Utemita/Optimizacion_Exo2/Analisis_DIP_Solucion_Definitiva.md

# Analisis Definitivo: Solucion al Problema DIP del Exoesqueleto

## A. Analisis de Causa Raiz - Por que el DIP es Constante

### A.1 Topologia actual del mecanismo

El exoesqueleto de mano (`CinematicaExoFinal.m` / `exo_18.py`) utiliza una cadena
cinematica de 4 etapas, todas accionadas por un unico motor:

| Etapa | Mecanismo | Salida |
|---|---|---|
| 1 | Par de engranes | theta_1, theta_2 (relacion fija) |
| 2 | 5 barras #1 + 4 barras #1 | theta_fp (falange proximal) |
| 3 | 5 barras #2 + 4 barras #2 | theta_fm (falange medial) |
| 4 | **Offset constante** | theta_fd = theta_fm + 38.78 deg |

La etapa 4 es la linea de codigo:

```python
theta_fd = theta_fm + theta_aux_fd   # theta_aux_fd = constante optimizable
```

Esto significa que el angulo relativo DIP-PIP es siempre constante. La falange
distal esta **rigidamente acoplada** a la medial, sin articulacion independiente.

### A.2 Por que el optimizador logra errores bajos a pesar de esto

Con los datos MOCAP originales (`mocap_indice_120pts.csv`), el rango DIP es solo
~20 grados. El optimizador compensa esta falta de movimiento DIP independiente
mediante:

1. Ajuste fino del offset constante para minimizar la distancia de Chamfer promedio.
2. La transformacion rigida global (R, t) absorbe parte de la discrepancia.
3. Los pesos W_IFP=0.25, W_IFD=0.375, W_TIP=0.375 permiten que la falange distal
   "siga" a la medial sin penalizacion excesiva.

Sin embargo, con datos de agarre fino (pinch) donde el DIP se mueve ~70 grados de
forma no lineal respecto al PIP, un offset constante **no puede** reproducir la
trayectoria correcta de la punta del dedo.

### A.3 Impacto fisico

Sin movimiento DIP independiente:
- La punta del dedo no realiza la curvatura necesaria para un agarre de pinza fina.
- El exoesqueleto no puede guiar la falange distal en posiciones de oposicion con
  el pulgar.
- El error en la punta aumenta significativamente con datos de pinch.

---

## B. Opcion 1: Acoplamiento Polinomial theta_aux_fd = f(delta_pip)

### B.1 Concepto

En lugar de un offset constante, hacer que `theta_aux_fd` dependa del estado del
mecanismo. La variable natural es la flexion relativa del PIP:

```
delta_pip = theta_fm - theta_fp
```

Esta cantidad es cero cuando la medial y la proximal estan alineadas, y crece a
medida que el dedo se cierra (la articulacion IFP se flexiona). La funcion de
acoplamiento es un polinomio:

```
theta_aux_fd = c0 + c1 * delta_pip + c2 * delta_pip^2
```

### B.2 Interpretacion de los coeficientes

- **c0** (termino constante): offset DIP en extension completa. Similar al antiguo
  theta_aux_fd = 38.78 deg. Rango: [0, pi].
- **c1** (termino lineal): tasa de flexion DIP por unidad de flexion PIP. Un valor
  positivo hace que el DIP se cierre mas rapido conforme el PIP se cierra.
  Rango: [-2, 2].
- **c2** (termino cuadratico): curvatura del acoplamiento. Permite que la relacion
  DIP-PIP sea no lineal (como en dedos reales). Rango: [-5, 5].

### B.3 Formulacion matematica

Dentro de `run_kinematics`, despues de resolver los mecanismos 5B#2 y 4B#2:

```python
# Calcular flexion relativa PIP
delta_pip = theta_fm - theta_fp

# Polinomio de acoplamiento DIP
theta_aux_fd = coeff_fd_0 + coeff_fd_1 * delta_pip + coeff_fd_2 * delta_pip**2

# Angulo absoluto de la falange distal
theta_fd = theta_fm + theta_aux_fd
```

### B.4 Realizacion fisica

Este acoplamiento polinomial se puede materializar en hardware como:
- **Perfil de leva (cam):** una leva en la articulacion IFP cuyo perfil controla
  la rotacion relativa del DIP. El polinomio define la geometria de la leva.
- **Ranura guia (slot):** una guia curva que convierte el movimiento PIP en
  flexion DIP a traves de un seguidor de levas.
- **Engranaje no circular:** un par de engranes con relacion de transmision
  variable que implementa la funcion polinomial.

### B.5 Ventajas

1. **Topologia identica:** los 4 mecanismos (5B+4B+5B+4B) no cambian.
2. **Complejidad minima:** solo se agregan 2 parametros (de 17 a 19 totales).
3. **Optimizable directamente:** los coeficientes se ajustan con la misma
   evolucion diferencial existente.
4. **Retrocompatible:** con c1=0, c2=0, el modelo se reduce al exo_18 original.
5. **No tiene problemas de ensamble:** no hay mecanismo fisico que pueda fallar
   en ciertas posiciones (a diferencia del 4B#3).
6. **Monotonia controlable:** se puede agregar una restriccion para que
   theta_aux_fd sea monotonamente creciente.

---

## C. Opcion 2: Acoplamiento Lineal theta_aux_fd = a0 + a1 * delta_pip

### C.1 Concepto

Caso particular de la Opcion 1 con c2 = 0:

```
theta_aux_fd = a0 + a1 * delta_pip
```

### C.2 Ventajas y limitaciones

**Ventajas:**
- Solo 1 parametro nuevo (de 17 a 18 totales).
- Muy facil de realizar fisicamente (engranaje lineal, cable con polea de radio
  fijo, o biela con relacion constante).
- Estable numericamente.

**Limitaciones:**
- La relacion DIP-PIP en un dedo real NO es lineal. La cinematica natural muestra
  aceleracion progresiva (el DIP se flexiona cada vez mas rapido conforme el PIP
  avanza).
- Con datos de pinch de alta amplitud (70 deg DIP), un modelo lineal puede no
  capturar la forma de la trayectoria de la punta.

---

## D. Opcion 3: Mecanismo Fisico de 4 Barras #3 (ya evaluada)

### D.1 Concepto

Agregar un tercer mecanismo de 4 barras que cruce la articulacion IFP, usando la
falange medial como bancada. Documentado en detalle en `Analisis_Modificacion_DIP.md`.

### D.2 Resultados obtenidos

- Excursion DIP: ~30 grados (con parametros nominales).
- Ensamble garantizado en todo el rango.
- **PROBLEMA CRITICO:** La falange distal se dobla hacia ARRIBA (hiperextension)
  en lugar de hacia abajo (flexion). El sentido de la flexion DIP es contrario
  al esperado.

### D.3 Analisis del problema de direccion

El problema de direccion ocurre porque la rama de ensamble seleccionada
(`phi3 - arccos(K3/R3)`) produce un alpha2_3 que decrece conforme se flexiona el
PIP. Para que la DIP se flexione (theta_fd aumente), alpha2_3 deberia aumentar, pero
la geometria del mecanismo impone lo contrario dada la configuracion de montaje.

Cambiar la rama de ensamble (`phi3 + arccos(K3/R3)`) o invertir signos de BETA no
es trivial, ya que puede provocar interferencias mecanicas o perdida de ensamble en
parte del rango.

### D.4 Problemas adicionales

- 5 parametros nuevos (complejidad del espacio de busqueda).
- Posibilidad de no-ensamble (`|K3| > R3`) en subconjuntos del rango.
- Restricciones geometricas de interferencia con los mecanismos existentes.
- El optimizador tiende a encontrar soluciones donde el 4B#3 se comporta como un
  offset casi constante (eliminando la ventaja de tenerlo).

---

## E. Opcion 4: Perfil de Leva o Ranura (cam/slot)

### E.1 Concepto

Disenar un perfil de leva sobre la articulacion IFP que imponga directamente el
angulo DIP como funcion del angulo PIP. La forma del perfil se optimizaria como
una spline o tabla de puntos.

### E.2 Ventajas

- Control total sobre la funcion de acoplamiento.
- Sin restricciones de ensamble.

### E.3 Limitaciones

- **Dificil de optimizar:** un perfil de leva parametrizado como spline requiere
  muchos puntos de control (10-20 parametros).
- **Fabricacion compleja:** requiere mecanizado CNC de precision.
- **No parametrizable facilmente** en el marco de optimizacion actual (evolucion
  diferencial con bounds simples).
- Si se usa un polinomio para definir el perfil de la leva, se reduce exactamente
  a la Opcion 1 (pero con la complejidad mecanica de fabricar una leva real).

---

## F. Recomendacion

### F.1 Solucion recomendada: Opcion 1 (Polinomio Cuadratico)

Se recomienda la **Opcion 1** por las siguientes razones:

1. **Conserva la topologia robusta** del mecanismo original (5B+4B+5B+4B) que
   ya demostro errores muy bajos en la optimizacion.

2. **Complejidad minima:** solo agrega 2 parametros al vector de diseno (de 17 a
   19 totales con los 3 coeficientes reemplazando el 1 constante anterior).

3. **Implementacion trivial:** 3 lineas de codigo en `run_kinematics`.

4. **Sin riesgos de ensamble:** no hay condiciones geometricas que puedan fallar.

5. **Retrocompatible:** equivalente al modelo actual con c1=c2=0.

6. **Optimizable con la infraestructura existente:** los coeficientes se agregan
   a bounds y se ajustan con la misma evolucion diferencial + Optuna.

7. **Realizable fisicamente:** el polinomio resultante define el perfil de una
   leva o engranaje no circular, cuya geometria se calcula directamente.

### F.2 Implementacion

El archivo `exo_19_dip_variable.py` implementa esta solucion:

- Vector de parametros: 19 elementos (los 17 originales con theta_aux_fd
  reemplazado por 3 coeficientes polinomiales).
- Datos MOCAP: carga `mocap_pinch_pizzolato.csv` (70 deg DIP) con fallback a
  `mocap_indice_120pts.csv`.
- Restriccion de monotonia: penaliza inversiones en la flexion DIP.
- Validacion: coeficientes (38.78 deg, 0, 0) reproducen el exo_18 original.

### F.3 Resultados esperados

Con el polinomio cuadratico, el optimizador puede:
- Encontrar la relacion DIP-PIP que mejor sigue los datos de pinch.
- Producir una trayectoria de la punta del dedo que se curva correctamente.
- Mantener errores bajos en IFP e IFD (topologia no cambia para esos puntos).
- Lograr flexion DIP progresiva y monotona (sin hiperextension).

---

## Resumen Comparativo

| Criterio | Opcion 1 (Polinomio) | Opcion 2 (Lineal) | Opcion 3 (4B#3) | Opcion 4 (Leva) |
|---|---|---|---|---|
| Params nuevos | +2 (19 total) | +1 (18 total) | +5 (22 total) | +10-20 |
| Topologia | Sin cambio | Sin cambio | Modifica | Sin cambio |
| Direccion DIP | Controlable | Controlable | Invertida | Controlable |
| Riesgo ensamble | Ninguno | Ninguno | Si | Ninguno |
| Precision DIP | Alta (no lineal) | Media (solo lineal) | Media | Alta |
| Fabricabilidad | Leva/engranaje | Cable/polea | Eslabones | Leva CNC |
| Dificultad implementacion | Minima | Minima | Alta | Alta |

**Conclusion:** La Opcion 1 (polinomio cuadratico) es la mejor combinacion de
simplicidad, precision y factibilidad para resolver el problema DIP sin
sacrificar la robustez del mecanismo original.
