Utemita/Optimizacion_Exo2/ReporteModeloCinemáticoExoPavel.pdf

## UNIVERSIDAD TECNOLÓGICA DE LA MIXTECA

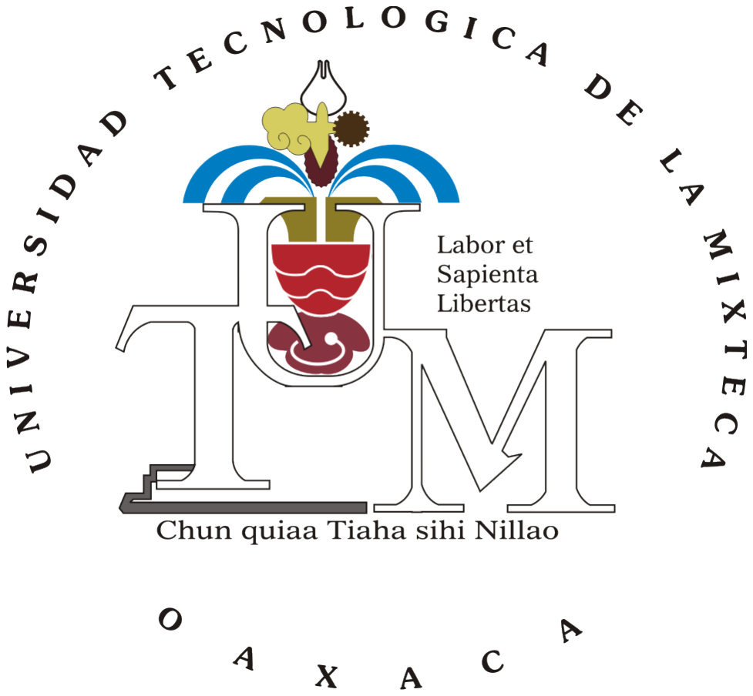
[picture p1: figure]

## “DISPOSITIVO MECATRÓNICO PARA ASISTENCIA EN REHABILITACIÓN DE LA MANO”

### SERVICIO SOCIAL

INGENIERÍA EN MECATRÓNICA
914-A

PRESENTA:

PALMA NICOLÁS PAVEL

PROFESOR:

DR. MANUEL ARIAS MONTIEL

HUAJUAPAN DE LEÓN, OAXACA, MÉXICO, NOVIEMBRE DE 2022

©Servicio Social. Mecatrónica 2022

ÍNDICE | iii

## Índice

1. Análisis cinemático del mecanismo propuesto | 1
1.3.1. Traslación del sistema de coordenadas secundario al sistema original . . | 15
2. Resumen de ecuaciones | 24
Referencias | 29
Anexos | 30
A. Código del análisis de posición del mecanismo completo implementado en
Matlab | 30

iv | Servicio Social

## Índice de figuras

1. | Mecanismo de movimiento propuesto | | 1
2. | Primer mecanismo de 5 barras | | 2
3. | Análisis de posición del primer mecanismo de 5 barras | | 2
4. | Primer mecanismo de 4 barras | | 5
5. | Análisis de posición del primer mecanismo de 4 barras | | 5
6. | Cálculo del ángulo de la falange proximal | | 9
7. | Cálculo de las coordenadas de la articulación IFP | | 9
8. Cálculo de las coordenadas del soporte Ps1 y Ps2
| | | 10
9. Cálculo de las coordenadas de la articulación PM4
| | | 11
10. Localización del segundo mecanismo de 5 barras | | 12
11. Segundo mecanismo de 5 barras a analizar | | 12
12. Análisis de posición del segundo mecanismo de 5 barras | | 13
13. Medición de los ángulos de entrada respecto al sistema de coordenadas secundario. 14
14. Traslación del sistema de coordenadas secundario al sistema original | | 16
15. Segundo mecanismo de 4 barras | | 18
16. Análisis de posición del segundo mecanismo de 4 barras | | 18
17. Cálculo de los ángulos θ1m42 y θ2m42 | | 19
18. Cálculo de las coordenadas del punto P3 | | 21
19. Cálculo de la posición de la falange medial | | 22
20. Cálculo de la posición de la falange distal | | 23
21. Parámetros establecidos por el diseñador | | 24

ÍNDICE DE TABLAS | v

## Índice de Tablas

1. Tabla de ecuaciones utilizadas para el análisis de posición del mecanismo completo 25

Análisis cinemático del mecanismo propuesto | 1

## 1. Análisis cinemático del mecanismo propuesto

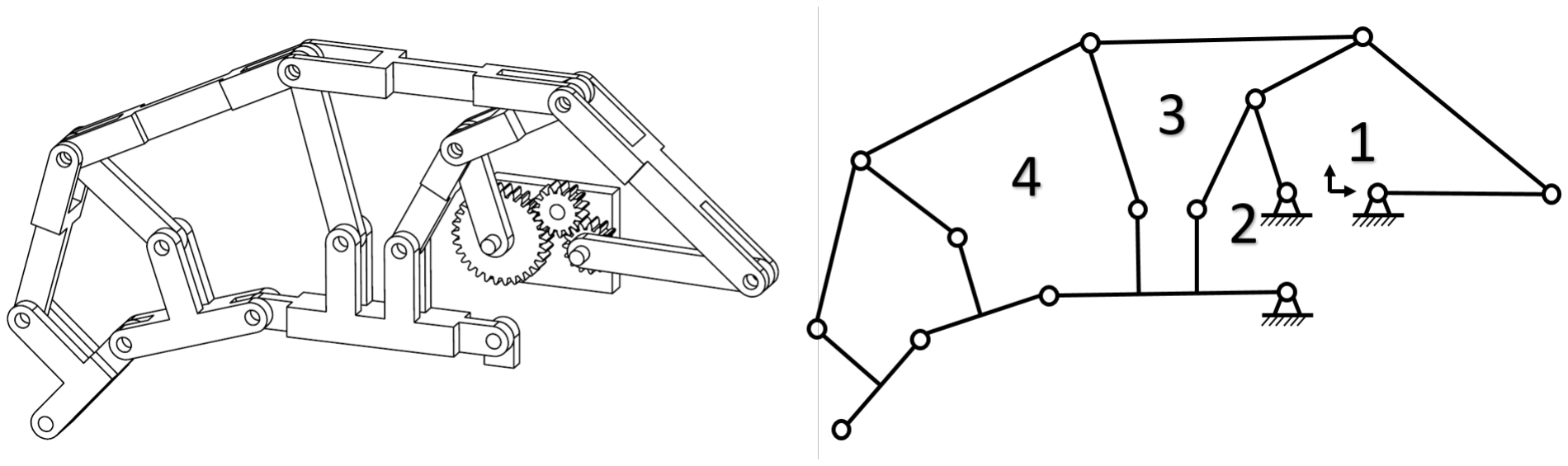
[picture p2: figure]

Figura 1: Mecanismo de movimiento propuesto.

En el presente trabajo se propone el mecanismo de flexo-extensión para los dedos de la mano de la Figura 1, perteneciente a un exoesqueleto de mano enfocado a la rehabilitación del miembro mencionado. Se trata de un exoesqueleto con un diseño de mecanismo tipo redundan-te (mecanismos de barras acoplados) el cual se compone por dos mecanismos de cinco barras (1 y 3) y dos mecanismos de cuatro barras (2 y 4). El mecanismo esta diseñado para poder controlar las articulaciones metacarpofalángicas (MCF), interfalángicas proximales (IFP) y distales (IFD), y con ellas las trayectorias de las falanges proximales, mediales y distales. En el caso de la falange distal debido al análisis del reducido rango de movimiento (ROM) se optó por fijar una posición fija de la falange distal respecto a la falange medial como parámetro de diseño. La falange proximal está representada por el eslabón cuaternario enlazado a la bancada y al mecanismo 2 y 3. La falange medial y distal es representada por los eslabones ternarios enlazados a los mecanismos 3 y 4.

Para realizar el análisis de posición de cada articulación y falange es necesario realizar un desacople cinemático del mecanismo completo con la finalidad de simplificarlo en mecanismos de cinco y cuatro barras que son más sencillos de comprender.

2 | Servicio Social

### 1.1. Primer mecanismo de 5 barras

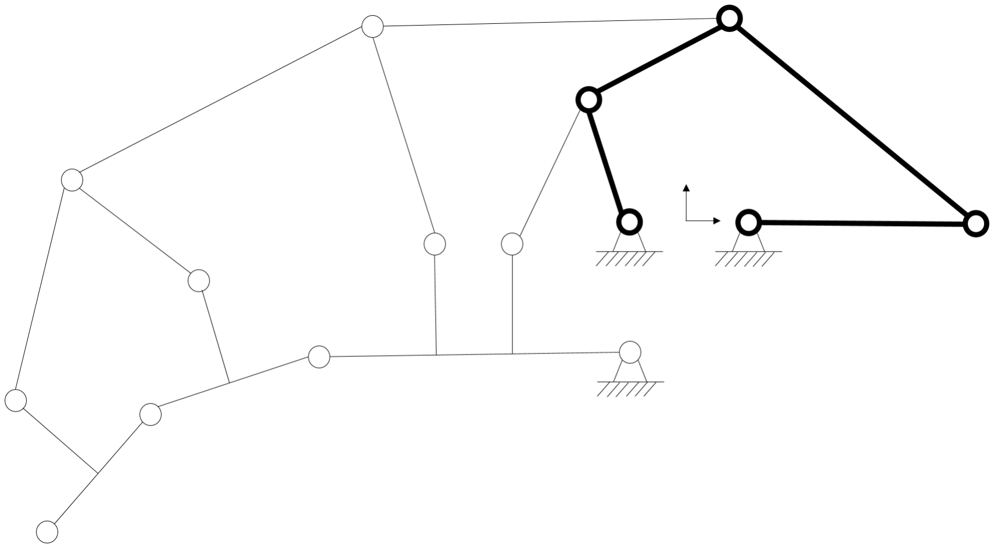
[picture p3: figure]

Figura 2: Primer mecanismo de 5 barras.

De acuerdo a la ecuación de Kutzbach el mecanismo de la Figura 2 posee 2 grados de libertad, sin embargo, se adaptó un sistema de engranajes al primer mecanismo de cinco barras, convirtiéndolo en un mecanismo de cinco barras engranado con un solo grado de libertad.

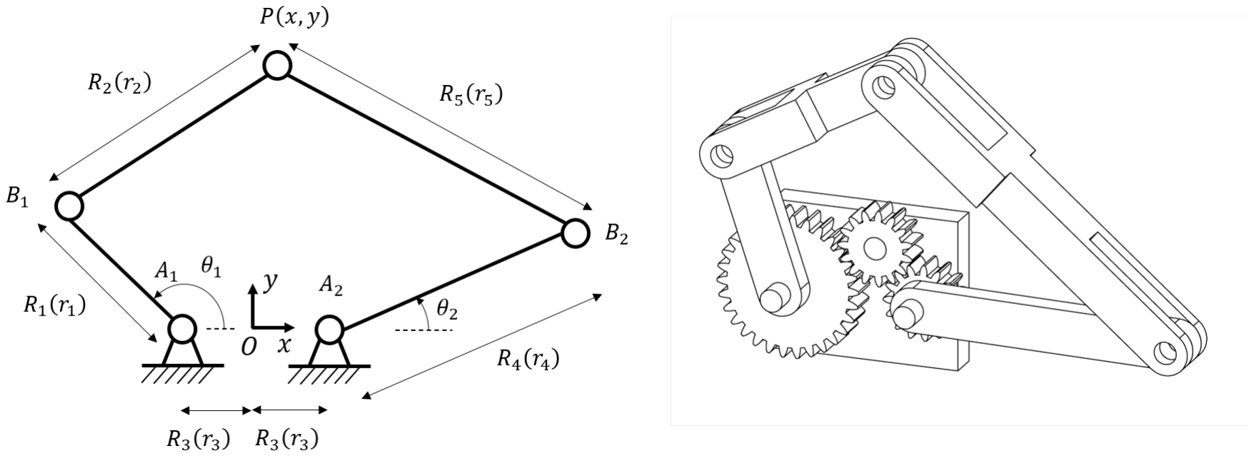
[picture p4: figure]

Figura 3: Análisis de posición del primer mecanismo de 5 barras.

El modelo cinemático del mecanismo de cinco barras en la Figura 3 es una adaptación de la propuesta hecha en [1] para un mecanismo de cinco barras simétrico paralelo. El mecanismo posee cinco juntas revolutas, de las cuales las dos juntas enlazadas a la bancada corresponden a las juntas actuadas (grados de libertad A1 y A2). Como se comentaba anteriormente, el sistema de engranajes permite reducir los grados de libertad a uno, el cual corresponde con la manivela de entrada denotada como R4 con su respectiva junta revoluta A2. Por lo tanto, el ángulo θ1 está definido con respecto a θ2 por la relación de engranaje:

θ1 = θ2(

Nent

Nsal

) | (1.1.1)

Análisis cinemático del mecanismo propuesto | 3

Donde Nent corresponde al número de dientes de entrada (piñón) y Nsal corresponde al número de dientes de salida (engrane). Con la finalidad de que ambas juntas tengan la misma dirección de giro se agrega un engrane loco para corregir la inversión de giro del engrane.

El origen del sistema de coordenadas del mecanismo de movimiento completo corresponde con el origen propuesto para el mecanismo inicial de cinco barras. Las juntas restantes son denotadas como B1, B2 y P. Debido a que se conocen los ángulos de entrada θ2 y θ1, el modelo se centra en determinar la posición del punto P respecto al origen propuesto. Es importante recalcar que la ubicación del origen respecto a las juntas A1 y A2) es de suma importancia ya que el origen debe coincidir exactamente con el punto medio entre ambas juntas (distancia r3 respecto a cada junta), juntas que además deben estar colocadas estrictamente dentro del mismo plano horizontal para el presente modelo propuesto.
Las posición del punto P, B1 y B2 con respecto al sistema de referencia están determinados por las posiciones de sus respectivos vectores:

P =

x
y
(1.1.2)

b1 =

r1cos(θ1) − r3
r1sen(θ1)
b2 =
r4cos(θ2) + r3
r4sen(θ2)
(1.1.3)

Para resolver el modelo cinemático se establecen las siguientes ecuaciones de restricción

|pb1| = r2 | |pb2| = r5 | (1.1.4)

Equivalente a

(x − r1cosθ1 + r3)

2 + (y − r1senθ1)

2 = r

2
2

(1.1.5)
(x − r4cosθ2 − r3)

2 + (y − r4senθ2)

2 = r

2
5

(1.1.6)

Evaluando y agrupando las ecuaciones (1.1.5) y (1.1.6)

x

2 + y

2 − 2(r1cosθ1 − r3)x − 2r1senθ1y − 2r1r3cosθ1 + r

2
1 + r

2
3 − r

2
2 = 0 | (1.1.7)
x

2 + y

2 − 2(r4cosθ2 + r3)x − 2r4senθ2y + 2r3r4cosθ2 + r

2
3 + r

2
4 − r

2
5 = 0 | (1.1.8)

Restando la ec. (1.1.8) a la ec. (1.1.7) y despejando a x se obtiene

x =

2(r1senθ1 − r4senθ2)y + 2r1r3cosθ1 + 2r3r4cosθ2 − r

2
1 + r

2
2 + r

2
4 − r

2
5
2(r4cosθ2 − r1cosθ1 + 2r3)

(1.1.9)

Introduciendo variables auxiliares

e =

r1senθ1 − r4senθ2
r4cosθ2 − r1cosθ1 + 2r3

(1.1.10)

f =

2(r1r3cosθ1 + r3r4cosθ2) − r

2
1 + r

2
2 + r

2
4 − r

2
5
2(r4cosθ2 − r1cosθ1 + 2r3)

(1.1.11)

Sustituyendo las ecuaciones (1.1.10) y (1.1.11) en la ec. (1.1.9)

x = PXP = ey + f | (1.1.12)

Sustituyendo la ec. (1.1.12) en la ec. (1.1.7) se obtiene

dy² + gy + h = 0 | (1.1.13)

donde

d = e

2 + 1 | (1.1.14)
g = 2(ef − er1cosθ1 + er3 − r1senθ1) | (1.1.15)

h = f

2 − 2f(r1cosθ1 − r3) − 2r1r3cosθ1 + r

2
1 + r

2
3 − r

2
2
| (1.1.16)

Finalmente resolviendo la ecuación cuadrática

y = PYP =

−g ±

p
g

2 − 4dh
2d

(1.1.17)

Análisis cinemático del mecanismo propuesto | 5

### 1.2. Primer mecanismo de 4 barras

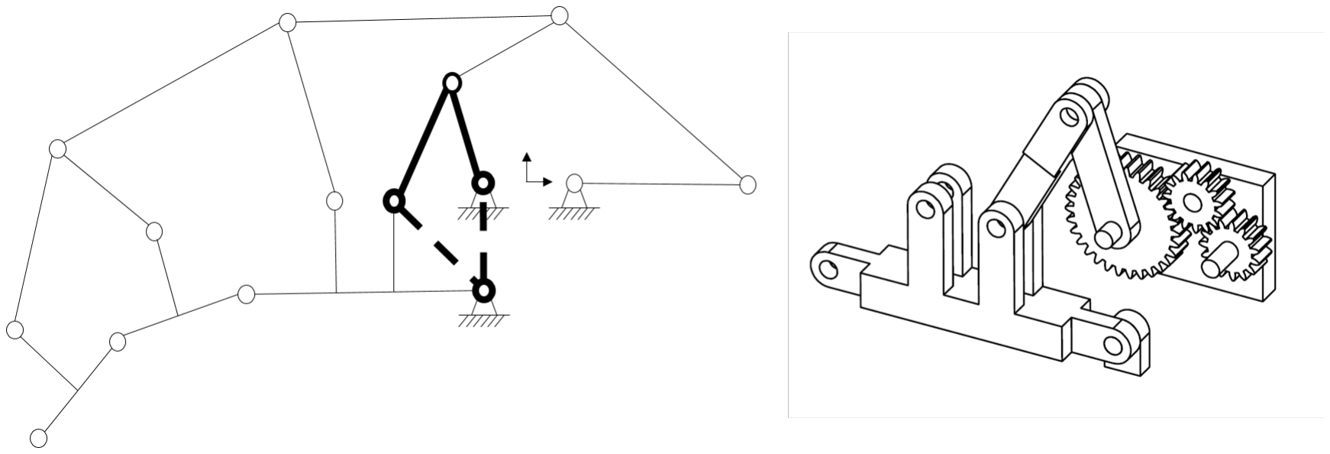
[picture p5: figure]

Figura 4: Primer mecanismo de 4 barras.

El modelo utilizado para el análisis cinemático del mecanismo de cuatro barras consiste en la suma de vectores a través de las ecuaciones de lazo vectorial debido a las características que presentan los vectores de representar la magnitud y dirección. El lazo vectorial se cierra sobre sí mismo y hace que la suma vectorial sea equivalente a cero [2]. De acuerdo a la ecuación de Kutzbach el mecanismo de la Figura 4 posee 1 grado de libertad. Por lo tanto, la posición del mecanismo quedará definida por el ángulo de entrada θ2 (véase Figura 5). El ángulo θ2 corresponde con el ángulo θ1 del modelo cinemático para el mecanismo de cinco barras.

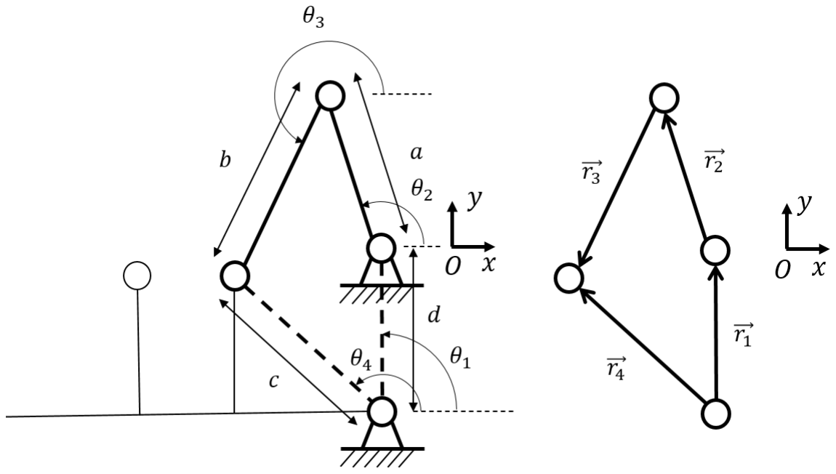
[picture p6: figure]

Figura 5: Análisis de posición del primer mecanismo de 4 barras.

El modelo propuesto en [2] utiliza la representación polar de vectores, para posteriormente, hacer uso de la identidad de Euler para obtener los componentes real e imaginario que representan el componente en x y componente en y respectivamente. Durante el desarrollo del modelo se hará referencia a los componentes real e imaginario como componentes en el eje x y en el eje y.

⃗r = reiθ

⃗r = rcosθ + irsenθ

Los parámetros establecidos por el diseñador son la longitud de los eslabones y el ángulo de la bancada respecto al eje horizontal. Considerando la Figura 5 se establece el significado de la notación utilizada

a : Longitud de la manivela b : Longitud del acoplador c : Longitud del balancín
d : Longitud de la bancada

θ1 : Ángulo de la bancada con la horizontal θ2 : Ángulo de la manivela con la horizontal θ3 : Ángulo del acoplador con la horizontal θ4 : Ángulo del balancín con la horizontal

Para obtener la adecuada medición de los ángulos de interés respecto a la referencia del eje horizontal se plantea la ecuación de lazo vectorial con base en el sentido de los vectores propuestos en el diagrama de la derecha de la Figura 5

⃗r1 + ⃗r2 + ⃗r3 = ⃗r4 | (1.2.1)

Sustituyendo las magnitudes y las direcciones en la ecuación de lazo y agrupando los términos conocidos en un lado de la ecuación

Componente en x:
c cos θ4 − b cos θ3 = a cos θ2 + d cos θ1 | (1.2.2)

Componente en y:
c sin θ4 − b sin θ3 = a sin θ2 + d sin θ1 | (1.2.3)

Se establecen

k1 = a cos θ2 + d cos θ1 | (1.2.4)
k2 = a sin θ2 + d sin θ1 | (1.2.5)

Para obtener el ángulo θ4 es necesario eliminar el ángulo θ3. Para ello se reordenan las ecuaciones (1.2.4) y (1.2.5) despejando de un lado al ángulo θ3, se elevan al cuadrado las ecuaciones reordenadas y, finalmente, se suman.

Análisis cinemático del mecanismo propuesto | 7

Se establecen

(−b cos θ3)

2 = (k1 − c cos θ4)

2

(−b sin θ3)

2 = (k2 − c sin θ4)

2

Sumando ambas ecuaciones y simplificando

2ck1 cos θ4 + 2ck2 sin θ4 − k3 = 0 | (1.2.6)

Donde

k3 = k

2
1 + k

2
2 + c

2 − b

2 | (1.2.7)

Para despejar el ángulo θ4 de la ecuación (1.2.6) se emplean las siguientes identidades trigonométricas

cos θ =

1 − tan²
(

θ
2

)
1 + tan²
(

θ
2

)

sin θ =

2 tan( θ
2

)
1 + tan²
(

θ
2

)

(1.2.8)

Sustituyendo las identidades en la ec. (1.2.6) y ordenando los términos

(−2k1c − k3) tan²
(

θ4
2

) + (4k2c) tan(θ4
2

) + (2k1c − k3) = 0

Se obtiene la ecuación cuadrática

A1 tan²
(

θ4
2

) + B1 tan(θ4
2
) + C1 = 0 | (1.2.9)

Donde

A1 = −2k1c − k3 | (1.2.10)
B1 = 4k2c | (1.2.11)
C1 = 2k1c − k3 | (1.2.12)

Resolviendo para tan( θ4
2

) y despejando a θ4

θ4 = 2 arctan(−B1 ±

p
B²
1 − 4A1C1
2A1
) | (1.2.13)

La elección del signo nos permite obtener dos configuraciones posibles que corresponden con la configuración abierta (signo −) y la configuración cerrada (signo +). Para nuestro análisis utilizaremos la configuración abierta donde los dos eslabones adyacentes al eslabón más corto no se cruzan.

Para obtener el ángulo θ3 es necesario eliminar el ángulo θ4 aplicando el proceso anterior. Para ello se reordenan las ecuaciones (1.2.4) y (1.2.5) despejando de un lado al ángulo θ4, se elevan al cuadrado las ecuaciones reordenadas y, finalmente, se suman.

Se establecen

(c cos θ4)

2 = (k1 + b cos θ3)

2

(c sin θ4)

2 = (k2 + b sin θ3)

2

Sumando ambas ecuaciones y simplificando

2bk1 cos θ3 + 2bk2 sin θ3 + k4 = 0 | (1.2.14)

Donde

k4 = k

2
1 + k

2
2 + b

2 − c

2 | (1.2.15)

Para despejar el ángulo θ3 de la ecuación (1.2.14) se emplean nuevamente las identidades trigonométricas de la ec.(1.2.8). Sustituyendo las identidades en la ec. (1.2.14) y ordenando los términos

(−2k1b + k4) tan²
(

θ3
2

) + (4k2b) tan(θ3
2

) + (2k1b + k4) = 0

Se obtiene la ecuación cuadrática

A2 tan²
(

θ3
2

) + B2 tan(θ3
2
) + C2 = 0 | (1.2.16)

Donde

A2 = −2k1b + k4 | (1.2.17)
B2 = 4k2b | (1.2.18)
C2 = 2k1b + k4 | (1.2.19)

Resolviendo para tan( θ3
2

) y despejando a θ3

θ3 = 2 arctan(−B2 ±

p
B²
2 − 4A2C2
2A2
) | (1.2.20)

Nuevamente para nuestro análisis utilizaremos la configuración abierta (signo −).

### 1.2.1. Cálculo de la posición de la falange proximal

El interés principal del análisis cinemático es obtener la trayectoria que recorre cada una de las articulaciones y falanges del dedo para todo valor de entrada de la manivela del primer

Análisis cinemático del mecanismo propuesto | 9

mecanismo de 5 barras. Por lo tanto, se procede a obtener el ángulo de desplazamiento de la falange proximal, así como las coordenadas de la articulación interfalángica proximal (IFP). De igual manera es importante calcular las coordenadas de los puntos de soporte Ps1 y Ps2 para el cálculo de posiciones de los mecanismos siguientes.

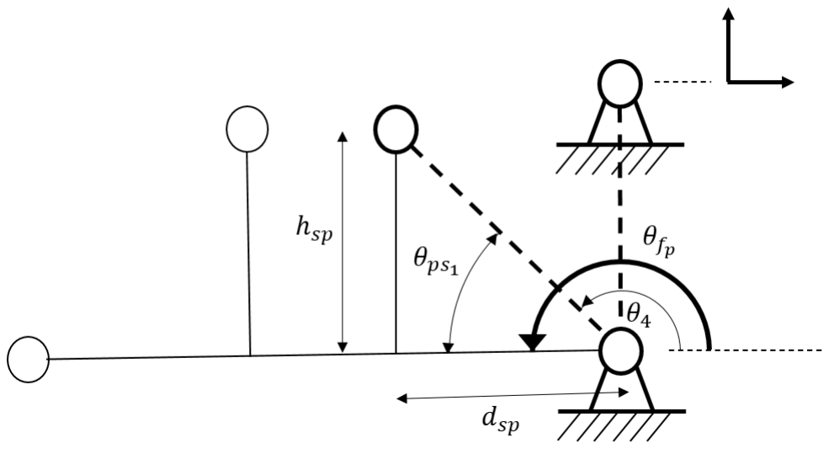
[picture p7: figure]

Figura 6: Cálculo del ángulo de la falange proximal.

En la Figura 6 se puede observar el diagrama correspondiente al cálculo del ángulo θf p. Este ángulo se calcula sumando el ángulo θ4, obtenido del primer mecanismo de cuatro barras y expresado en la ec. (1.2.13), y el ángulo θps1
, el cual es un ángulo fijo establecido por dos parámetros de diseño, la altura que poseen los soportes de cada falange respecto a la falange misma (hsp) y la distancia de los soportes de la falange proximal respecto a sus extremos (dsp). De esta manera el ángulo es determinado con la siguiente ecuación

θf p = θ4 + θps1 = θ4 + arctan(hsp

dsp

) | (1.2.21)

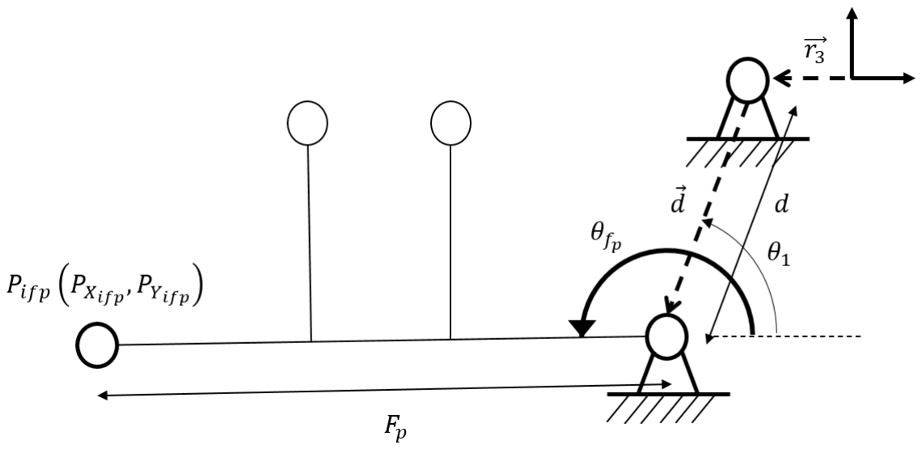
[picture p8: figure]

Figura 7: Cálculo de las coordenadas de la articulación IFP.

Para realizar el cálculo de las coordenada se realizó una suma vectorial entre los vectores ⃗r3,

⃗d y F⃗
p

P⃗

if p = ⃗r3 + ⃗d + F⃗
p
Al fijar como parámetro de diseño que el vector ⃗r3 se encontrará en el eje horizontal, sus componentes se reducen solo a la magnitud r3 sobre el eje horizontal. Descomponiendo en sus componentes en x y y
PXifp = Fp cos θf p − d cos θ1 − r3 | (1.2.22)
PYifp = Fp sin θf p − d sin θ1 | (1.2.23)

Recordando que θ1 corresponde al ángulo formado entre el eje horizontal y la bancada del mecanismo de 4 barras. Este es un parámetro establecido por el diseñador.

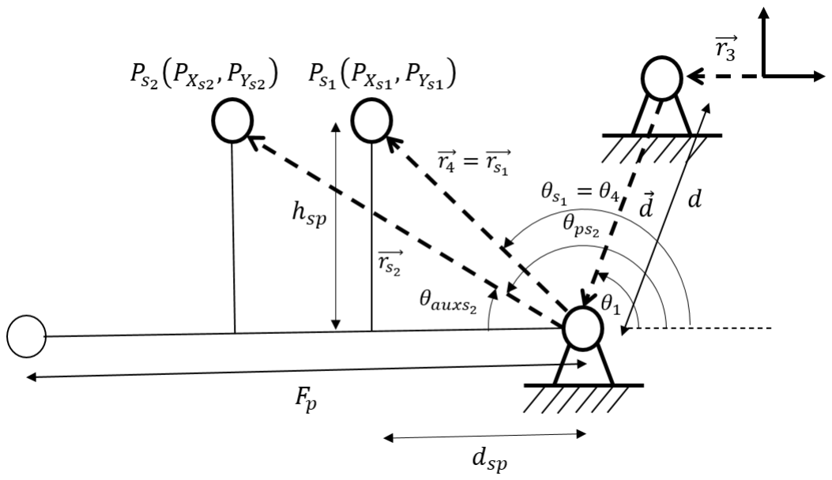
[picture p9: figure]

Figura 8: Cálculo de las coordenadas del soporte Ps1 y Ps2

Para el cálculo de las coordenadas de los dos soportes de la falange proximal se establece una suma vectorial correspondiente para cada soporte que involucra a los vectores ⃗r3,

⃗d y ⃗rs1
o ⃗rs2

respectivamente. Las ecuaciones se plantean de la siguiente manera

P⃗

s1 = ⃗r3 + ⃗d + ⃗rs1

P⃗

s2 = ⃗r3 + ⃗d + ⃗rs2

En el caso del soporte 1, el ángulo θs1

corresponde al ángulo del balancín θ4 obtenido en el mecanismo de 4 barras. Descomponiendo en su componentes x y y

Análisis cinemático del mecanismo propuesto | 11
PXS1 = c cos θ4 − d cos θ1 − r3 | (1.2.24)
PYS1 = c sin θ4 − d sin θ1 | (1.2.25)

El ángulo θauxs2

es un ángulo fijo determinado por la distancia vertical y horizontal del soporte 2 respecto a la falange proximal. Con el ángulo calculado θauxs2 y el ángulo de la falange proximal (θf p) se procede a calcular la magnitud y dirección del vector ⃗rs2

| ⃗rs2

| =

q
h

2
sp + (Fp − dsp)

2
(1.2.26)

θps2 = θf p − θauxs2 = θf p − arctan( hsp

Fp − dsp

) | (1.2.27)

Finamente calculando los componentes en x y y del soporte 2

PXS2 = | ⃗rs2
| cos θps2 − d cos θ1 − r3 | (1.2.28)
PYS2 = | ⃗rs2
|sin θps2 − d sin θ1 | (1.2.29)

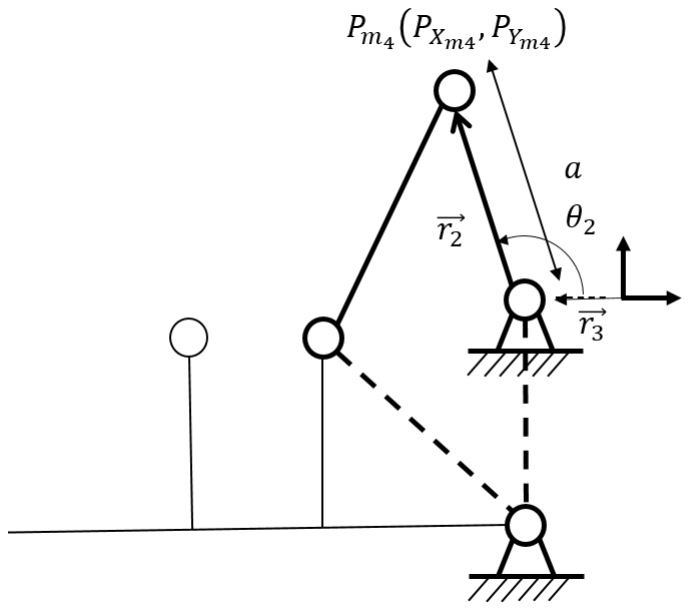
[picture p10: figure]

Figura 9: Cálculo de las coordenadas de la articulación PM4

Finalmente, en la Figura 9 se muestra el cálculo de las coordenadas del punto PM4

, el
cual será de utilidad para cálculos posteriores
PXM4 = a cos θ2 − r3 | (1.2.30)
PYM4 = a sin θ2 | (1.2.31)

### 1.3. Segundo mecanismo de 5 barras

EL análisis del segundo mecanismo de 5 barras requiere de un análisis especial, ya que a diferencia de los mecanismos analizados anteriormente, este no posee una bancada fija. Este hecho provoca que se plantee un sistema de coordenadas secundario para poder determinar las posiciones del mecanismo en cada instante.

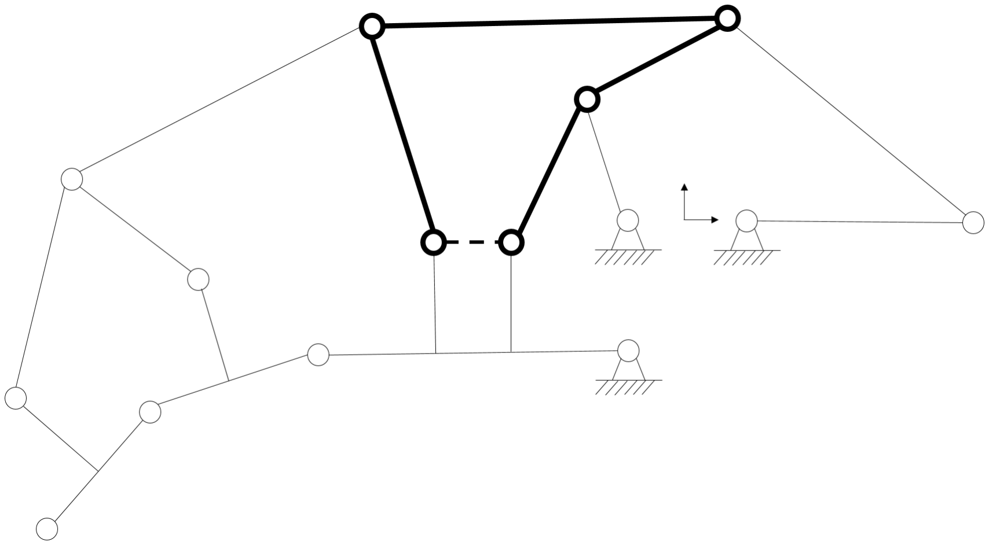
[picture p11: figure]

Figura 10: Localización del segundo mecanismo de 5 barras.

Como se mencionó anteriormente, la ecuación de Kutzbach aplicada al mecanismo de la Figura 10 estipula 2 grados de libertad. Estos dos grados de libertad serán controlados por la salida de movimiento de los primeros mecanismos de 4 y 5 barras analizados.

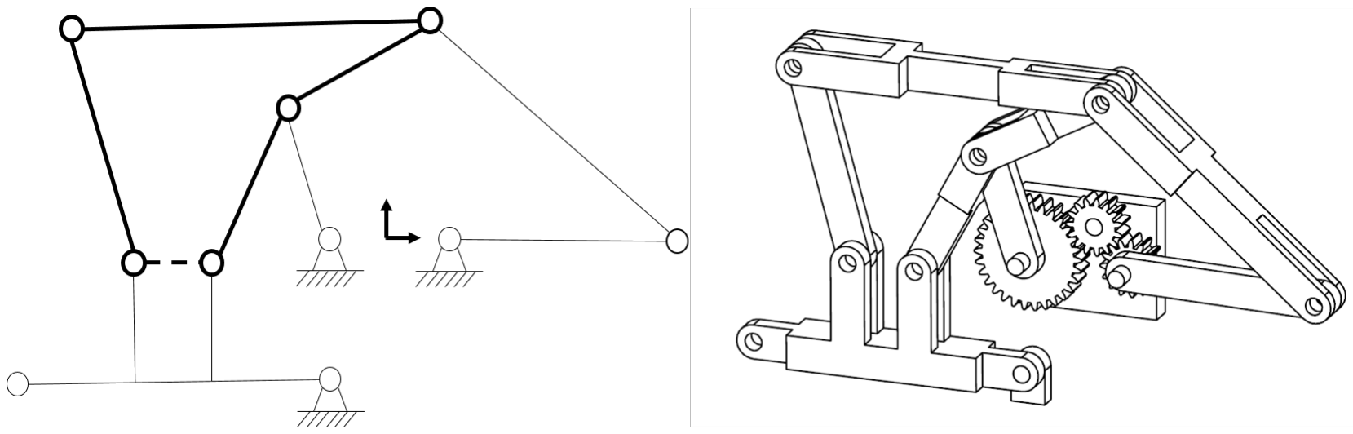
[picture p12: figure]

Figura 11: Segundo mecanismo de 5 barras a analizar.

El modelo cinemático del mecanismo de cinco barras resaltado en la Figura 11 es el mismo modelo aplicado al primer mecanismo analizado, con la diferencia que los ángulos de entrada serán proporcionados por las salidas de los mecanismos anteriores. Para el presente mecanismo las juntas actuadas (grados de libertad A1 y A2) corresponden a las juntas revolutas Ps1 y Pm4 cuyos ángulos de movimiento quedan determinados por la posición de las juntas Ps1 y Ps2

, así como Pm4 y P respectivamente.

Análisis cinemático del mecanismo propuesto | 13

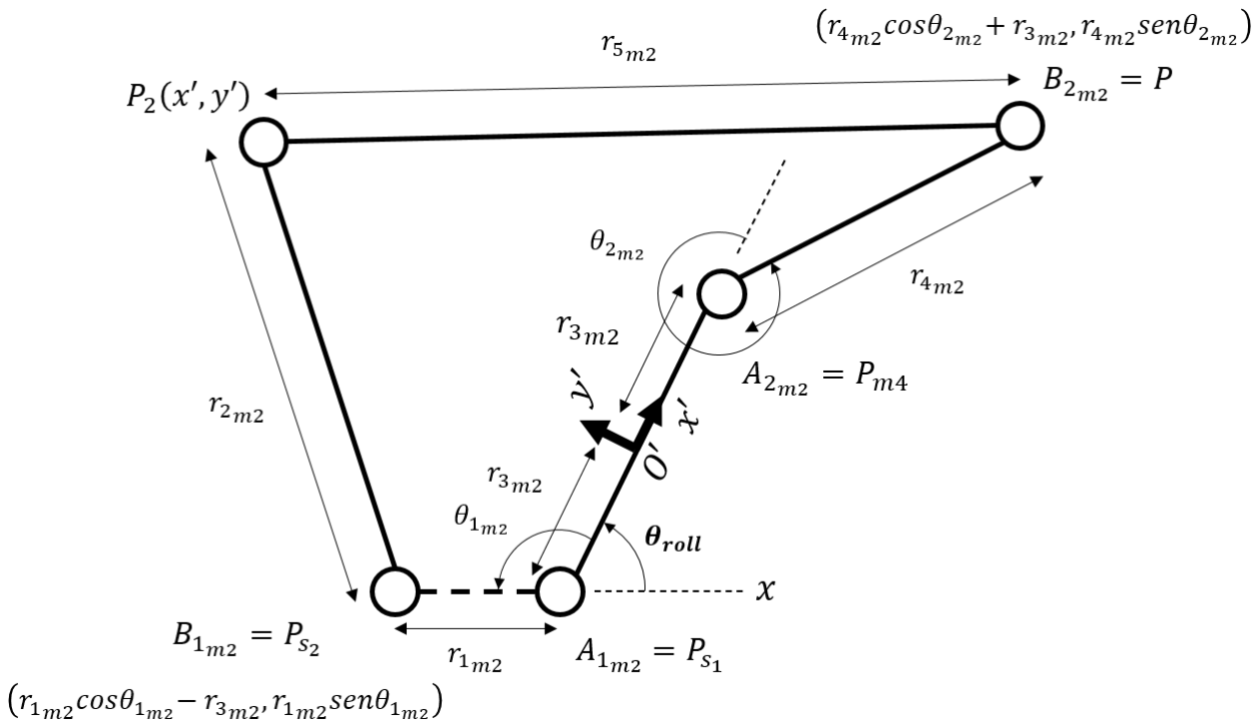
[picture p13: figure]

Figura 12: Análisis de posición del segundo mecanismo de 5 barras.

Antes de continuar con el modelo propuesto se debe estipular que el eje horizontal del sistema de coordenadas secundario será colineal al acoplador del primer mecanismo de 4 barras en todo momento. Así mismo, el origen de coordenadas se posicionará en la distancia media entre las juntas actuadas. Esto con la finalidad de plantear el modelo de la misma forma que para el primer mecanismo de 5 barras. Cabe recalcar que el ángulo θroll es de suma importancia, ya que a través de él se hace la traslación de ángulos y coordenadas del sistema secundario al primario y viceversa. A continuación se presenta la ecuación (1.3.1), la cual determina este ángulo utilizando la pendiente entre ambos extremos de la bancada móvil que corresponde con el acoplador del primer mecanismo de 4 barras

θroll = arctan

PYm4 − PYs1

PXm4 − PXs1

(1.3.1)

Otro aspecto muy importante consiste en definir el sistema de referencia con el que se medirán los ángulos y coordenadas del modelo. Para reducir la complejidad del problema, el sistema de referencia para los cálculos del modelo propuesto corresponderá con el sistema de coordenadas secundario. Posteriormente se presentará la transformación de estas mediciones al sistema original. En la Figura 13 se muestran los diagramas con los parámetros necesarios para la determinación de los ángulos de entrada.

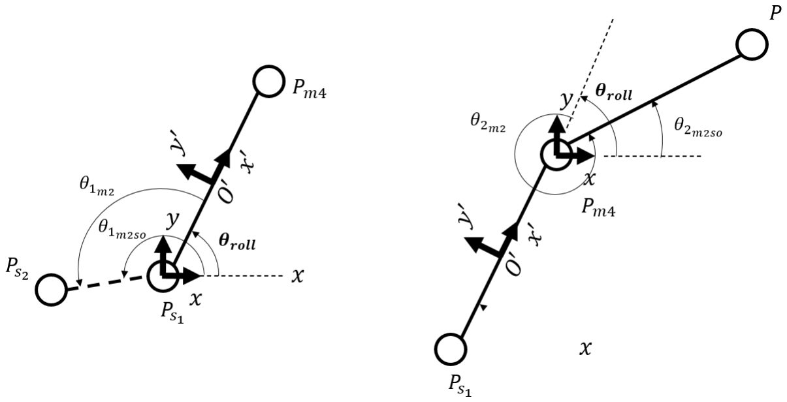
[picture p14: figure]

Figura 13: Medición de los ángulos de entrada respecto al sistema de coordenadas secundario.

A partir de los diagramas mostrados se establecen las ecuaciones correspondientes a cada ángulo de entrada de la siguiente manera. El sufijo so corresponde al ángulo medido a partir del sistema original.

θ1m2so = arctan( PYs2 − PYs1

PXs2 − PXs1

) | (1.3.2)
θ1m2 = θ1m2so − θroll | (1.3.3)

θ2m2so = arctan( PYP − PYm4

PXP − PXm4

) | (1.3.4)
θ2m2 = θ2m2so − θroll | (1.3.5)

Finalmente se realiza el mismo planteamiento y procedimiento utilizado para el primer mecanismo de 5 barras

P2 =

x

′
y

′

(1.3.6)

b1m2 =

r1m2

cos(θ1m2

) − r3m2

r1m2

sen(θ1m2

)

b2m2 =
r4m2

cos(θ2m2

) + r3m2

r4m2

sen(θ2m2

)

(1.3.7)

Para resolver el modelo cinemático se establecen las siguientes ecuaciones de restricción

|p2b1m2

| = r2m2

|p2b2m2

| = r5m2

(1.3.8)

Análisis cinemático del mecanismo propuesto | 15

Equivalente a

(x

′ − r1m2
cosθ1m2 + r3m2

)

2 + (y

′ − r1m2
senθ1m2

)

2 = r

2
2m2

(1.3.9)
(x

′ − r4m2
cosθ2m2 − r3m2

)

2 + (y

′ − r4m2
senθ2m2

)

2 = r

2
5m2

(1.3.10)

Con el propósito de reducir el número de ecuaciones se omitirá la repetición del procedimiento de cálculo de las siguientes ecuaciones finales

em2 =

r1m2

senθ1m2 − r4m2
senθ2m2

r4m2

cosθ2m2 − r1m2
cosθ1m2 + 2r3m2

(1.3.11)

fm2 =

2(r1m2
r3m2

cosθ1m2 + r3m2
r4m2

cosθ2m2

) − r

2
1m2 + r

2
2m2 + r

2
4m2 − r

2
5m2
2(r4m2

cosθ2m2 − r1m2
cosθ1m2 + 2r3m2

)

(1.3.12)

x

′ = PX′

P 2

= em2y

′ + fm2 | (1.3.13)

dm2y

′2 + gm2y

′ + hm2 = 0 | (1.3.14)

donde

dm2 = e

2
m2 + 1 | (1.3.15)

gm2 = 2(em2fm2 − em2r1m2

cosθ1m2 + em2r3m2 − r1m2

senθ1m2) | (1.3.16)

hm2 = f

2
m2 − 2fm2(r1m2

cosθ1m2 − r3m2

) − 2r1m2
r3m2

cosθ1m2 + r

2
1m2 + r

2
3m2 − r

2
2m2
| (1.3.17)

Finalmente resolviendo la ecuación cuadrática

y

′ = PY
′
P 2

=

−gm2 ±

p
g

2
m2 − 4dm2hm2
2dm2

(1.3.18)

### 1.3.1. Traslación del sistema de coordenadas secundario al sistema original

Para el correcto análisis de posición es necesario trasladar las coordenadas del sistema secundario al sistema principal, para ello se requiere plantear un vector auxiliar (P⃗
aux) que
representará la posición del origen móvil del sistema secundario con respecto al origen del sistema de coordenadas principal. Las consideraciones necesarias se presentan en la Figura 14.

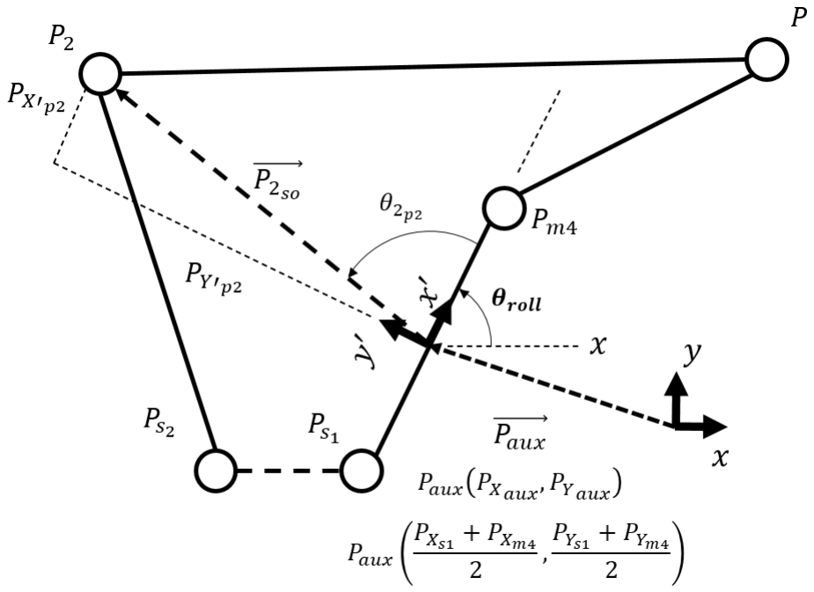
[picture p15: figure]

Figura 14: Traslación del sistema de coordenadas secundario al sistema original.

Las coordenadas del punto final del vector auxiliar (origen móvil) se calculan a través de la ecuación de punto medio entre dos puntos

PXaux =

PXs1 + PXm4
2

(1.3.19)

PYaux =

PYs1 + PYm4
2

(1.3.20)

Para poder calcular las coordenadas del punto P2 con respecto al sistema original se propone la suma vectorial siguiente

P⃗

2 = P⃗

aux + P⃗
2so | (1.3.21)

La magnitud y dirección del vector P2so

con respecto al sistema secundario se establecen de la siguiente manera

Análisis cinemático del mecanismo propuesto | 17

P⃗

2so = |P⃗
2so |∠θ2p2

|P⃗
2so | =

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
(1.3.22)

θ2p2 = arctan(

PY
′
P 2
PX′
P 2
) | (1.3.23)

Finalmente reescribiendo respecto al sistema de coordenadas original basado en la ec.(1.3.21)

P⃗

2 = P⃗

aux + |P⃗
2|∠(θ2p2 + θroll)

Expresado en sus componentes x y y

PXP 2 = |P⃗
2so | cos(θ2p2 + θroll) + PXaux | (1.3.24)

PYP 2 = |P⃗
2so |sin(θ2p2 + θroll) + PYaux | (1.3.25)

### 1.4. Segundo mecanismo de 4 barras

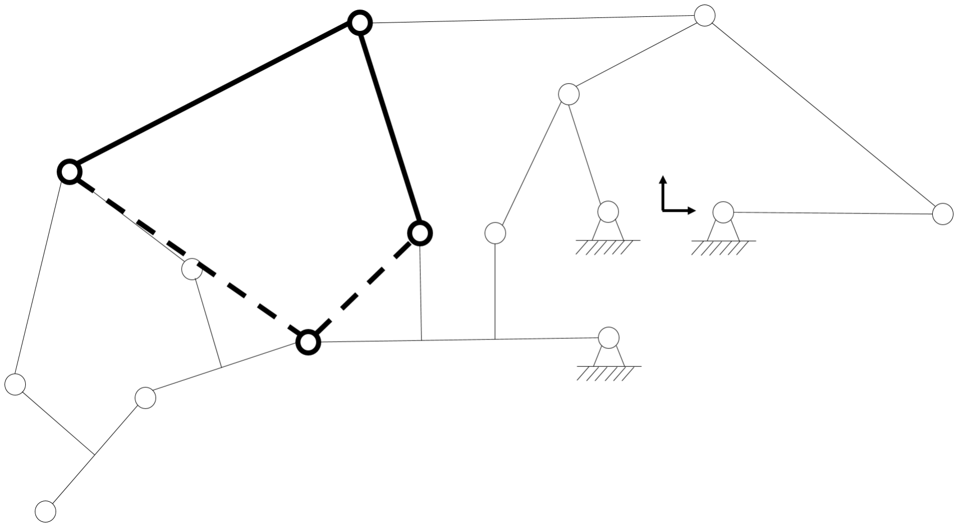
[picture p16: figure]

Figura 15: Segundo mecanismo de 4 barras.

El modelo utilizado para el análisis cinemático del segundo mecanismo de cuatro barras nuevamente consiste en la suma de vectores a través de las ecuaciones de lazo vectorial. De acuerdo a la ecuación de Kutzbach el mecanismo de la Figura 15 posee 1 grado de libertad. Por lo tanto, la posición del mecanismo quedará definida por el ángulo de entrada θ2m42 (véase Figura 16), ángulo que es determinado a su vez por las posiciones de los mecanismos anteriores.

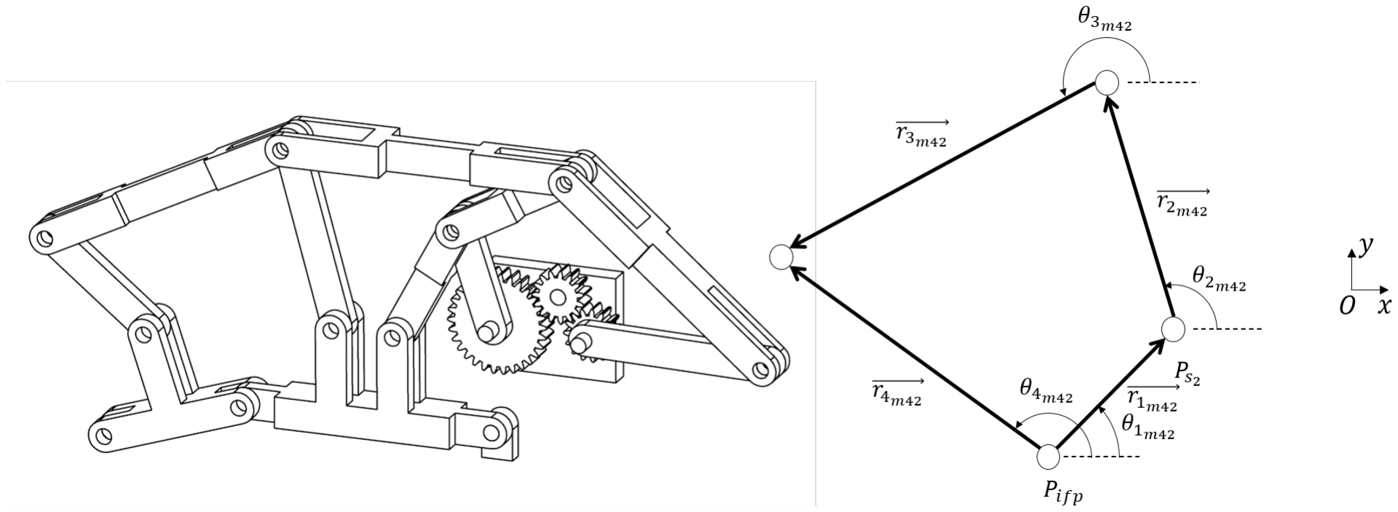
[picture p17: figure]

Figura 16: Análisis de posición del segundo mecanismo de 4 barras.

Los parámetros establecidos por el diseñador son la longitud de los eslabones. En este caso el ángulo de la bancada respecto al eje horizontal dependerá de la posición de los mecanismos anteriores y no del diseñador. Considerando las Figuras 16 y 17 se establece el significado de la notación utilizada

Análisis cinemático del mecanismo propuesto | 19

a2 : Longitud de la manivela b2 : Longitud del acoplador c2 : Longitud del balancín
d2 : Longitud de la bancada

θ1m42 : Ángulo de la bancada con la horizontal θ2m42 : Ángulo de la manivela con la horizontal θ3m42 : Ángulo del acoplador con la horizontal θ4m42 : Ángulo del balancín con la horizontal

Para obtener la adecuada medición de los ángulos de interés respecto a la referencia del eje horizontal se plantea la ecuación de lazo vectorial con base en el sentido de los vectores propuestos en el diagrama de la derecha de la Figura 16

1⃗r m42 + 2⃗r m42 + 3⃗r m42 = 4⃗r m42 | (1.4.1)

Previo al cálculo de los ángulos de cada eslabón es importante establecer las ecuaciones que determinan los ángulos de entrada que estarán variando constantemente de acuerdo a la posición del resto de los mecanismos. Estos ángulos son el ángulo θ1m42 , que corresponde al ángulo de la bancada con la horizontal, y el ángulo θ2m42 , que corresponde al grado de libertad del mecanismo (manivela).

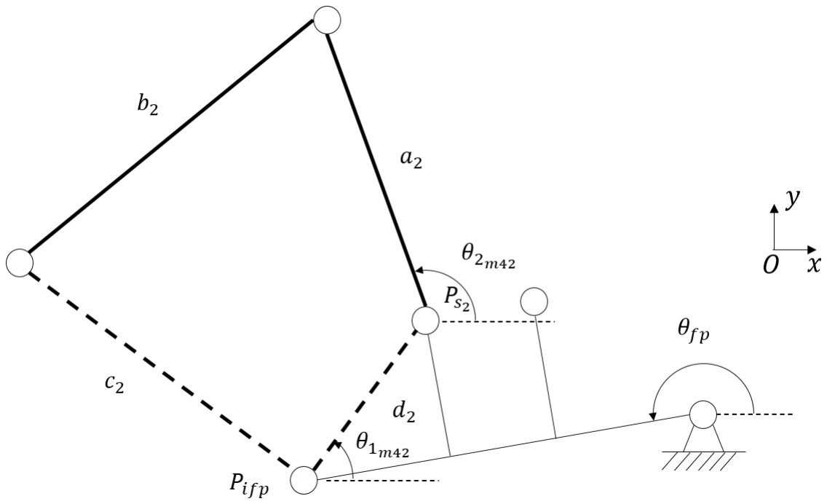
[picture p18: figure]

Figura 17: Cálculo de los ángulos θ1m42 y θ2m42 .

Con base en la Figura 17 se pueden establecer las siguientes ecuaciones θ1m42 = arctan( PYs2 − PYIF P

PXs2 − PXIF P

) | (1.4.2)

θ2m42 = arctan( PYP 2 − PYs2

PXP 2 − PXs2

) | (1.4.3)

De la misma manera en que se obtuvieron las ecuaciones de diseño para el primer mecanismo de 4 barras se obtuvieron las siguientes ecuaciones

k1m2 = a2 cos θ2m42 + d2 cos θ1m42 | (1.4.4)
k2m2 = a2 sin θ2m42 + d2 sin θ1m42 | (1.4.5)

Para obtener el ángulo θ4m42 es necesario eliminar el ángulo θ3m42 . Se establece

k3m2 = k

2
1m2 + k

2
2m2 + c

2
2 − b

2
2 | (1.4.6)

Se obtiene la ecuación cuadrática

A1m2

tan²
(

θ4m42
2

) + B1m2

tan(θ4m42
2
) + C1m2 = 0 | (1.4.7)

Donde

A1m2 = −2k1m2

c2 − k3m2

(1.4.8)

B1m2 = 4k2m2

c2 | (1.4.9)

C1m2 = 2k1m2

c2 − k3m2 | (1.4.10)

Resolviendo para tan( θ4m42
2

) y despejando a θ4m42

θ4m2 = 2 arctan(

−B1m2 ±

q
B²
1m2 − 4A1m2C1m2

2A1m2

) | (1.4.11)

Como en el mecanismo de 4 barras anterior se elije la configuración abierta donde los dos eslabones adyacentes al eslabón más corto no se cruzan.

Para obtener el ángulo θ3m42 es necesario eliminar el ángulo θ4m42 aplicando el proceso anterior. Se establece

k4m2 = k

2
1m2 + k

2
2m2 + b

2
2 − c

2
2
| (1.4.12)

Se obtiene la ecuación cuadrática

Análisis cinemático del mecanismo propuesto | 21

A2m2

tan²
(

θ3m42
2

) + B2m2

tan(θ3m42
2
) + C2m2 = 0 | (1.4.13)

Donde

A2m2 = −2k1m2
b2 + k4m2

(1.4.14)

B2m2 = 4k2m2

b2 | (1.4.15)

C2m2 = 2k1m2

b2 + k4m2 | (1.4.16)

Resolviendo para tan( θ3m42
2

) y despejando a θ3m42

θ3m42 = 2 arctan(

−B2m2 ±

q
B²
2m2 − 4A2m2C2m2

2A2m2

) | (1.4.17)

Nuevamente para nuestro análisis utilizaremos la configuración abierta (signo −).
Para cálculos posteriores resulta conveniente el cálculo de las coordenadas del punto 3 P3 que se observa en la Figura 18.

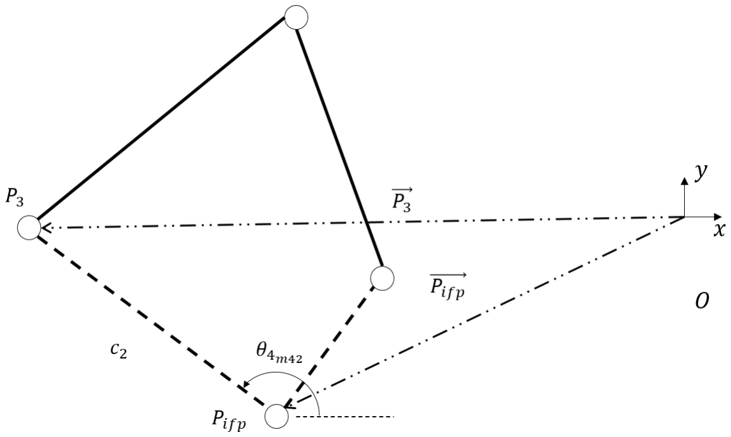
[picture p19: figure]

Figura 18: Cálculo de las coordenadas del punto P3.

De acuerdo a la Figura mostrada se establecen las siguientes ecuaciones

PXP 3 = PXIF P + c2 cos θ4m42 | (1.4.18)
PYP 3 = PYIF P + c2 sin θ4m42 | (1.4.19)

### 1.4.1. Cálculo de la posición de la falange medial

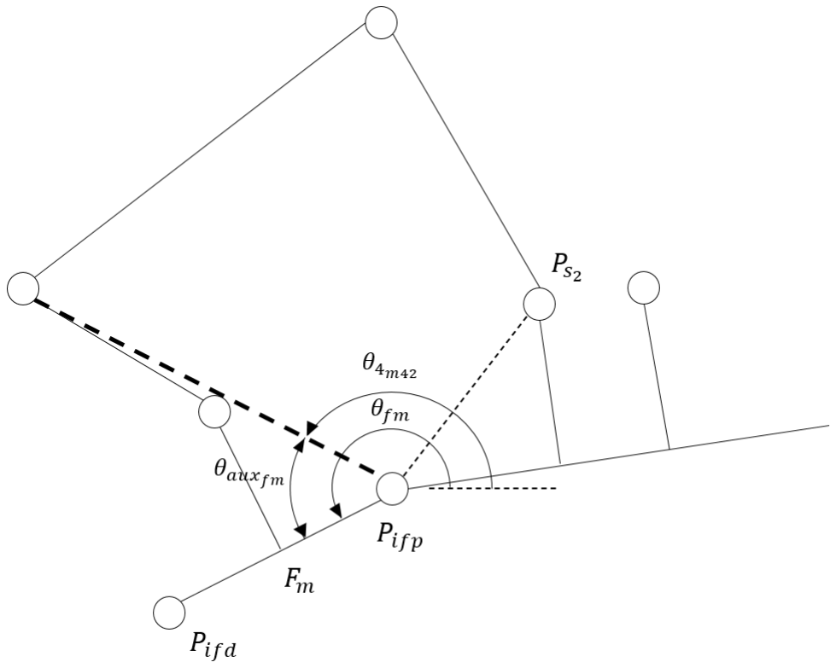
[picture p20: figure]

Figura 19: Cálculo de la posición de la falange medial.

Como se observa en la Figura 19, el ángulo de la falange medial θfm y las coordenadas de la articulación interfalángica distal (IFD) Pif d pueden ser calculadas directamente tenien-do conocimiento del ángulo θauxfm, el cual es un parámetro que establece el diseñador. Las ecuaciones se establecen de la siguiente forma

θfm = θ4m42 + θauxfm | (1.4.20)
PXifd = Fm cos θfm + PXifp | (1.4.21)
PYifd = Fm sin θfm + PYifp | (1.4.22)

Análisis cinemático del mecanismo propuesto | 23

### 1.4.2. Cálculo de la posición de la falange distal

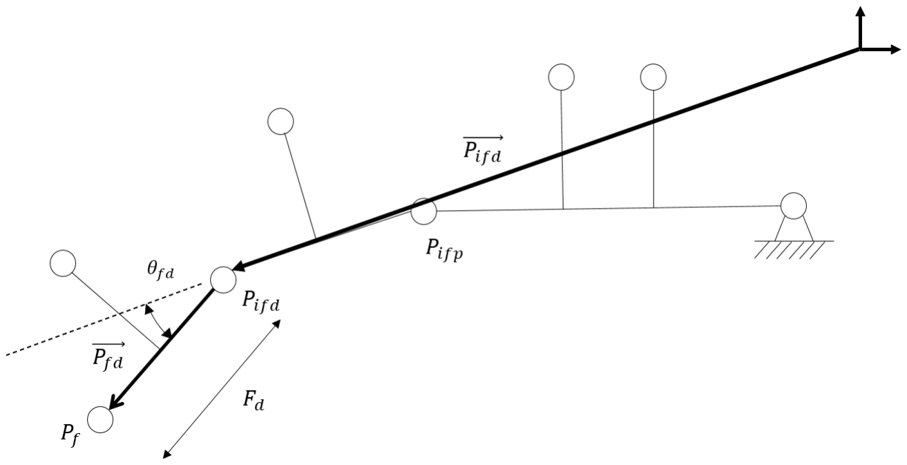
[picture p21: figure]

Figura 20: Cálculo de la posición de la falange distal.

Para determinar las coordenadas del punto final del dedo se necesita haber definido el ángulo que mantiene la falange distal con respecto a la falange medial θauxfd , ángulo que se contempló como un parámetro del diseñador a partir del hecho de que este ángulo será fijo. Se decidió que este ángulo fuera fijo debido a su bajo ROM que presenta. A continuación se presentan las ecuaciones para determinar las coordenadas finales

θf d = θfm + θauxfd | (1.4.23)
PXf = Fd cos θf d + PXifd | (1.4.24)
PYf = Fd sin θf d + PYifd | (1.4.25)

## 2. Resumen de ecuaciones

Finamente, se presenta un breve resumen de las ecuaciones de interés en el análisis de posición del mecanismo completo con la finalidad de poder implementar las ecuaciones en el software numérico de preferencia, tal como el ejemplo presentado en el Anexo A desarrollado en Matlab®. Este resumen se presenta en forma tabular en la Tabla 1.

Adicionalmente se presenta en la Figura 21 los parámetros de diseño que deben ser establecidos por el diseñador para aplicar correctamente el modelo cinemático desarrollado. Con esta Figura y las presentadas durante el análisis de cada mecanismo individual resulta sencillo interpretar que valores toman cada una de las magnitudes y ángulos de las ecuaciones. De igual manera se puede revisar la descripción del código desarrollado en Matlab®en el Anexo A, donde se describe más a detalle la asignación de valores y parámetros de diseño.

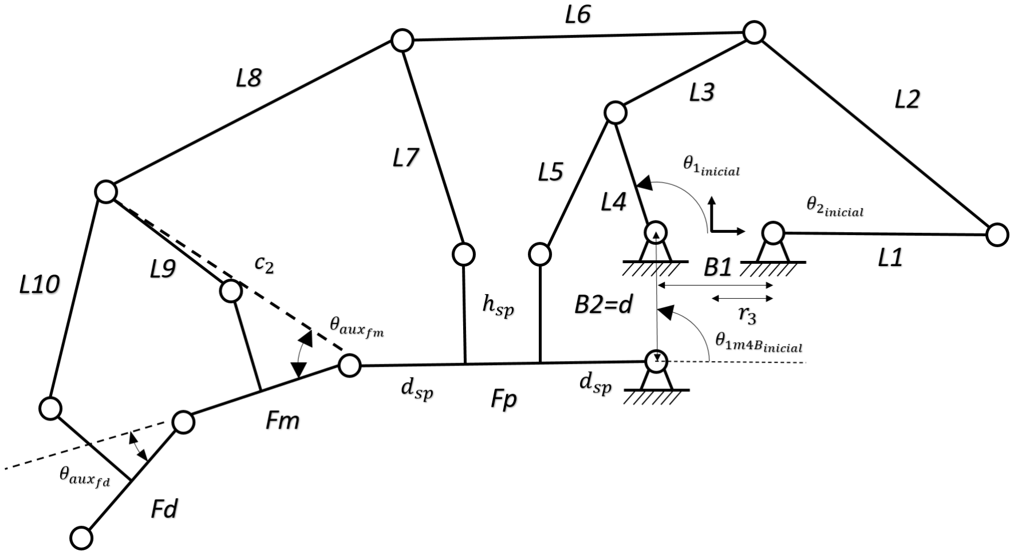
[picture p22: figure]

Figura 21: Parámetros establecidos por el diseñador.

Resumen de ecuaciones | 25

Tabla 1: Tabla de ecuaciones utilizadas para el análisis de posición del mecanismo completo

Primer mecanismo de 5 barras
Ecuación | Num. ec. | Observaciones
r1senθ1−r4senθ2 e = r4cosθ2−r1cosθ1+2r3 2 2 2 2 2(r1r3cosθ1+r3r4cosθ2)−r 1+r 2+r 4−r f = 5 2(r4cosθ2−r1cosθ1+2r3) 2 + 1 d = e g = 2(ef − er1cosθ1 + er3 − r1senθ1) h = f 2 − 2f(r1cosθ1 − r3) − 2r1r3cosθ1 + r 1 + r 2 3 − r 2 2 2 x = PXP = ey + f √ −g± g 2−4dh y = PYP = 2d | (1.1.10) (1.1.11) (1.1.14) (1.1.15) (1.1.16) (1.1.12) (1.1.17) | Considerar los cuadrantes al aplicar la tan-gente inversa

Primer mecanismo de 4 barras k1 = a cos θ2 + d cos θ1

k2 = a sin θ2 + d sin θ1

k3 = k

2
1 + k

2
2 + c

2 − b

2

k4 = k

2
1 + k

2
2 + b

2 − c

2

A1 = −2k1c − k3

B1 = 4k2c

C1 = 2k1c − k3

A2 = −2k1b + k4

B2 = 4k2b

C2 = 2k1b + k4

θ3 = 2 arctan( ⁻B2±

√
B²
2−4A2C2
2A2

)

θ4 = 2 arctan( ⁻B1±

√
B²
1−4A1C1
2A1

)

(1.2.4)

(1.2.5)

(1.2.7)

(1.2.15)

(1.2.10)

(1.2.11)

(1.2.12)

(1.2.17)

(1.2.18)

(1.2.19)

(1.2.20)

(1.2.13)

Considerar los
cuadrantes al
aplicar la tan-gente inversa

Ecuación | Num. ec. | Observaciones

θf p = θ4 + θps1 = θ4 + arctan( hsp

dsp

)

PXifp = Fp cos θf p − d cos θ1 − r3

PYifp = Fp sin θf p − d sin θ1

PXS1 = c cos θ4 − d cos θ1 − r3

PYS1 = c sin θ4 − d sin θ1

| ⃗rs2

| =

q
h

2
sp + (Fp − dsp)

2

θps2 = θf p − θauxs2 = θf p − arctan( hsp
Fp−dsp

)

PXS2 = | ⃗rs2

| cos θps2 − d cos θ1 − r3

PYS2 = | ⃗rs2

|sin θps2 − d sin θ1

PXM4 = a cos θ2 − r3

PYM4 = a sin θ2

(1.2.21)

(1.2.22)

(1.2.23)

(1.2.24)

(1.2.25)

(1.2.26)

(1.2.27)

(1.2.28)

(1.2.29)

(1.2.30)

(1.2.31)

Considerar los
cuadrantes al
aplicar la tan-gente inversa

Segundo mecanismo de 5 barras

θroll = arctan PYm4−PYs1

PXm4−PXs1

θ1m2so = arctan( PYs2−PYs1

PXs2−PXs1

)

θ1m2 = θ1m2so − θroll

θ2m2so = arctan( PYP

−PYm4

PXP

−PXm4

)

θ2m2 = θ2m2so − θroll

em2 =

r1m2

senθ1m2−r4m2
senθ2m2

r4m2

cosθ2m2−r1m2
cosθ1m2+2r3m2

fm2 =

2(r1m2
r3m2

cosθ1m2+r3m2
r4m2

cosθ2m2

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
2(r4m2

cosθ2m2−r1m2
cosθ1m2+2r3m2

)

dm2 = e

2
m2 + 1

(1.3.1)

(1.3.2)

(1.3.3)

(1.3.4)

(1.3.5)

(1.3.11)

(1.3.12)

(1.3.15)

Considerar los
cuadrantes al
aplicar la tan-gente inversa

Resumen de ecuaciones | 27
Ecuación | Num. ec. | Observaciones

gm2 = 2(em2fm2 − em2r1m2
cosθ1m2+

em2r3m2 − r1m2

senθ1m2)

hm2 = f

2
m2 − 2fm2(r1m2

cosθ1m2 − r3m2

)
−2r1m2
r3m2

cosθ1m2 + r

2
1m2 + r

2
3m2 − r

2
2m2

x

′ = PX′

P 2

= em2y

′ + fm2

y

′ = PY
′
P 2

=

−gm2±

√
g

2
m2−4dm2hm2
2dm2

PXaux =

PXs1+PXm4
2

PYaux =

PYs1+PYm4
2

|P⃗
2so | =

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
θ2p2 = arctan(

PY ′
P 2
PX′
P 2

)

PXP 2 = |P⃗
2so | cos(θ2p2 + θroll) + PXaux

PYP 2 = |P⃗
2so |sin(θ2p2 + θroll) + PYaux

(1.3.16)

(1.3.17)

(1.3.13)

(1.3.18)

(1.3.19)

(1.3.20)

(1.3.22)

(1.3.23)

(1.3.24)

(1.3.25)

Considerar los
cuadrantes al
aplicar la tan-gente inversa

Segundo mecanismo de 4 barras

θ1m42 = arctan( PYs2−PYIF P

PXs2−PXIF P

)

θ2m42 = arctan( PYP 2

−PYs2

PXP 2

−PXs2

)

k1m2 = a2 cos θ2m42 + d2 cos θ1m42

k2m2 = a2 sin θ2m42 + d2 sin θ1m42

k3m2 = k

2
1m2 + k

2
2m2 + c

2
2 − b

2
2

k4m2 = k

2
1m2 + k

2
2m2 + b

2
2 − c

2
2

A1m2 = −2k1m2

c2 − k3m2

B1m2 = 4k2m2

c2

(1.4.2)

(1.4.3)

(1.4.4)

(1.4.5)

(1.4.6)

(1.4.12)

(1.4.8)

(1.4.9)

Considerar los
cuadrantes al
aplicar la tan-gente inversa

Ecuación | Num. ec. | Observaciones

C1m2 = 2k1m2

c2 − k3m2

A2m2 = −2k1m2
b2 + k4m2

B2m2 = 4k2m2

b2

C2m2 = 2k1m2
b2 + k4m2

θ3m42 = 2 arctan( ⁻B2m2±

√B²

2m2

−4A2m2C2m2

2A2m2

)

θ4m2 = 2 arctan( ⁻B1m2±

√B²

1m2

−4A1m2C1m2

2A1m2

)

PXP 3 = PXIF P + c2 cos θ4m42

PYP 3 = PYIF P + c2 sin θ4m42

θfm = θ4m42 + θauxfm

PXifd = Fm cos θfm + PXifp

PYifd = Fm sin θfm + PYifp

θf d = θfm + θauxfd

PXf = Fd cos θf d + PXifd

PYf = Fd sin θf d + PYifd

(1.4.10)

(1.4.14)

(1.4.15)

(1.4.16)

(1.4.17)

(1.4.11)

(1.4.18)

(1.4.19)

(1.4.20)

(1.4.21)

(1.4.22)

(1.4.23)

(1.4.24)

(1.4.25)

Considerar los
cuadrantes al
aplicar la tan-gente inversa

Referencias | 29

## Referencias

[1] X.-J. Liu, J. Wang, y G. Pritschow, “Kinematics, singularity and workspace of planar 5r symmetrical parallel mechanisms,” Mechanism and Machine Theory, vol. 41, no. 2, pp. 145–169, 2006, ISSN 0094-114X, Disponible en: https://www.sciencedirect.com/science/article/pii/S0094114X05000923. (https://www.sciencedirect.com/science/article/pii/S0094114X05000923)
[2] R. L. Norton, Diseño de maquinaria, Síntesis y análisis de máquinas y mecanismos, 4a ed., McGRAW-HILL/INTERAMERICANA EDITORES, S.A. DE C.V., 2009, ISBN 978-970-10-6884-7.

## Anexos

## A. Código del análisis de posición del mecanismo completo implementado en Matlab

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

3
4 c l e a r a l l
5 c l o s e a l l
6 c l c

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

13
14 Bancada1 = 1 8;
15 Bancada2 = 2 0;
16 Link1 = 3 5;
17 Link2 = 4 9;
18 Link3 = 2 5;
19 Link4 = 2 0;
20 Link5 = 2 5;
21 Link6 = 5 5;
22 Link7 = 3 5;
23 Link8 = 5 2;
24 Link9 = 2 5;
25 Link10 = 3 5;
26 c2 = 4 6 . 8 1 ; | %Di s t a n ci a e n t r e l a a r t . IFP y e l punto P3
27 TETHA2inicial = 0 ;
28 TETHA1inicial = 1 0 9;
29 THETA14B = 9 0;
30 hsp = 1 7;
31 dsp = 1 8;
32 f p = 4 7 . 9 1 ;
33 fm = 2 7 . 5 2 ;
34 f d = 2 4;
35 THETAauxfm = 5 4. 3 4 7 9 5 7 2 6; 36 THETAauxfd = 3 0;
37 omega2 = 1 0;
38 ren g = 2 ;
39 % A si g n a ci o n de l o s p a r ame t r o s de di s e n o a l a s v a r i a b l e s u t i l i z a d a s en l a s 40 % e c u a ci o n e s

41
42 % Primer mecanismo de 5 b a r r a s
43 r 4 = Link1 ;
44 r 5 = Link2 ;
45 r 2 = Link3 ;
46 r 1 = Link4 ;
47 r 3 = Bancada1 / 2;

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

Anexos | 31
58 r3m2 = Link5 / 2; | %Mitad d el Link 5 d el mecanismo completo
59 r4m2 = Link3 ;
60 r5m2 = Link6 ;

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

70
71 % Bancada1 = 1 8;
72 % Bancada2 = 2 0;
73 % Link1 = 3 5;
74 % Link2 = 4 9;
75 % Link3 = 2 5;
76 % Link4 = 2 0;
77 % Link5 = 2 5;
78 % Link6 = 5 5;
79 % Link7 = 3 5;
80 % Link8 = 5 2;
81 % Link9 = 2 5;
82 % Link10 = 3 5;
83 % c2 = 4 6 . 8 1 ; | %Di s t a n ci a e n t r e l a a r t . IFP y e l punto P3
84 % TETHA2inicial = 0 ; | %Angulo de l a manivela de ENTRADA en l a p o s i c i o n
85 % | e s t a c i o n a r i a en g r ad o s ;
86 % TETHA1inicial = 1 0 9; | %Angulo de l a manivela d el mecanismo de 4 b a r r a s en
87 % | l a p o s i c i o n e s t a c i o n a r i a en g r ad o s ;
88 % THETA14B = 9 0; | %Angulo de l a bancada d el mecanismo de 4 b a r r a s
89 % | i n i c i a l en g r ad o s con r e s p e c t o a l a h o r i z o n t a l
90 % hsp = 1 7; | %Al tu r a de l o s s o p o r t e s de l a f a l a n g e s
91 % dsp = 1 8; | %d i s t a n c i a d el s o p o r t e f a l a n g e prox . a l a a r t .
92 % f p = 4 7 . 9 1 ; | %Largo de l a f a l a n g e p r oxim al
93 % fm = 2 7 . 5 2 ; | %Largo de l a f a l a n g e medi al
94 % f d = 2 4; | %Largo de l a f a l a n g e d i s t a l
95 % THETAauxfm = 5 4. 3 4 7 9 5 7 2 6;
96 % THETAauxfd = 3 0;
97 % omega2=10; | %Vel ocid ad de l a manivela en RPM
98 % ren g = 2 ; | %R el a ci o n de e n g r a n a j e p r o p u e s t a

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

116
117 tiempo ( j )=( j −1)∗dtiempo ; %I ni ci am o s en tiempo c e r o
118 THETA2( j )=( j −1)∗ d the t a+TETHA2inicial ; % Angulo de l a manivela d el M5Barras 119 t h e t a 2 ( j )=THETA2( j )∗ pi / 1 8 0; %an gul o de l a manivela d el M5Barras en r a di a n e s

120
121 THETA1( j )=THETA2( j ) / ren g + TETHA1inicial ; %De l a r e l . de e n g r a n a j e maniv . 4B 122 t h e t a 1 ( j )=THETA1( j )∗ pi / 1 8 0; %Angulo de manivela 4B en r a di a n e s

123
124

125
126
127 %CALCULOS PARA EL MECANISMO INICIAL DE 5 BARRAS

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

137
138 pyP ( j ) = ( − g + s q r t ( g .^ 2 − 4∗daux∗h ) ) / ( 2∗ daux ) ;
139 pxP ( j ) = e ∗pyP ( j ) + f ;

140
141 % pyN ( j ) = ( − g − s q r t ( g .^ 2 − 4∗daux∗h ) ) / ( 2∗ daux ) ; 142 % pxN ( j ) = e ∗pyN ( j ) + f ;

143
144
145
146 % CALCULOS PARA EL MECANISMO INICIAL DE 4 BARRAS 147 k1=d∗ c o s ( theta14B )+a∗ c o s ( t h e t a 1 ( j ) ) ;
148 k2=d∗ s i n ( theta14B )+a∗ s i n ( t h e t a 1 ( j ) ) ;
149 k3=k1^2+k2^2+c^2−b ^ 2;
150 k4=−c^2+b^2+k1^2+k2 ^ 2;
151 A1=−k3−2∗k1∗ c ;
152 B1=4∗k2∗ c ;
153 C1=2∗k1∗c−k3 ;
154 A2=k4−2∗k1∗b ;
155 B2=4∗k2∗b ;
156 C2=2∗k1∗b+k4 ;

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

171 end
172 THETA4c( j )=2∗ atan ( t a n t h e t a 4 1 )∗1 8 0 / pi ; %t h e t a 4 c ruz ad o en g r ad o s 173 THETA4a( j )=2∗ atan ( t a n t h e t a 4 2 )∗1 8 0 / pi ; %t h e t a 4 a b i e r t o en g r ad o s
174 | i f THETA4a( j )<0
175 | THETA4a( j ) = 360 + THETA4a( j ) ;

176 end

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

183
184 %C al c ul o d el s u j e t a d o r de l a f a l a n g e p r oxim al
185 pxS1 ( j ) = c ∗ c o s ( t h e t a 4 a ( j ) ) − d∗ c o s ( theta14B ) − r 3 ;
186 pyS1 ( j ) = c ∗ s i n ( t h e t a 4 a ( j ) ) − d∗ s i n ( theta14B ) ;
187 THETAps2( j ) = THETAfp( j ) − atand ( hsp / ( fp−dsp ) ) ;
188 t h e t a p s 2 ( j )= deg2rad (THETAps2( j ) ) ; %Angulo de l a f a l a n g e p r oxim al en r a di a n e s 189 r s 2 = s q r t ( hsp^2 + ( f p − dsp ) ^ 2 );
190 pxS2 ( j ) = r s 2 ∗ c o s ( t h e t a p s 2 ( j ) ) − d∗ c o s ( theta14B ) − r 3 ;
191 pyS2 ( j ) = r s 2 ∗ s i n ( t h e t a p s 2 ( j ) ) − d∗ s i n ( theta14B ) ;

Anexos | 33

192
193 %C al c ul o d el punto Pm4
194 pxM4( j ) = a∗ c o s ( t h e t a 1 ( j ) ) − r 3 ; 195 pyM4( j ) = a∗ s i n ( t h e t a 1 ( j ) ) ;

196
197
198
199 % CALCULOS PARA EL SEGUNDO MECANISMO DE 5 BARRAS CON RESPECTO AL
200 % SISTEMA SECUNDARIO
201 THETAroll ( j ) = atan2d (pyM4( j ) − pyS1 ( j ) , pxM4( j ) − pxS1 ( j ) ) ;
202 t h e t a r o l l ( j ) = deg2rad ( THETAroll ( j ) ) ; %Angulo de cambio de l o s e j e s en r a di a n e s

203
204 THETA1m2so( j ) = atan2d ( pyS2 ( j ) − pyS1 ( j ) , pxS2 ( j ) − pxS1 ( j ) ) ;
205 | i f THETA1m2so( j )<0
206 | THETA1m2so( j ) = 360 + THETA1m2so( j ) ;

207 end
208 theta1m2so ( j ) = deg2rad (THETA1m2so( j ) ) ; %Angulo de en t r ad a 1 con r e s p e c t o
209 | %a l s o en r a di a n e s
210 THETA1m2( j ) = THETA1m2so( j ) − THETAroll ( j ) ;
211 theta1m2 ( j ) = deg2rad (THETA1m2( j ) ) ; %Angulo de en t r ad a 1 en r a di a n e s

212
213 THETA2m2so( j ) = atan2d ( pyP ( j ) − pyM4( j ) , pxP ( j ) − pxM4( j ) ) ;
214 | i f THETA2m2so( j )<0
215 | THETA2m2so( j ) = 360 + THETA2m2so( j ) ;

216 end
217 theta2m2so ( j ) = deg2rad (THETA2m2so( j ) ) ; %Angulo de en t r ad a 2 con r e s p e c t o
218 | %a l s o en r a di a n e s
219 THETA2m2( j ) = THETA2m2so( j ) − THETAroll ( j ) ;
220 theta2m2 ( j ) = deg2rad (THETA2m2( j ) ) ; %Angulo de en t r ad a 2 en r a di a n e s

221
222 %R el a ci o n e s o b t e ni d a s de l a s e c u a ci o n e s
223 temp2 = ( r4m2∗ c o s ( theta2m2 ( j ) ) − r1m2∗ c o s ( theta1m2 ( j ) ) + 2∗r3m2 ) ;
224 em2 = ( r1m2∗ s i n ( theta1m2 ( j ))− r4m2∗ s i n ( theta2m2 ( j ) ) ) / temp2 ;
225 temp3=(2∗( r1m2∗r3m2∗ c o s ( theta1m2 ( j ))+r3m2∗r4m2∗ c o s ( theta2m2 ( j ))) −r1m2^2+r2m2^2+r4m2^2−r5m2 ^ 2 ); 226 fm2 = temp3 / ( 2∗( r4m2∗ c o s ( theta2m2 ( j ) ) − r1m2∗ c o s ( theta1m2 ( j ) ) + 2∗r3m2 ) ) ;
227 %C o e f i c i e n t e s de l a e c u a ci o n c u a d r a ti c a
228 dauxm2 = em2^2 + 1 ;
229 gm2 = 2∗( em2∗fm2 − em2∗r1m2∗ c o s ( theta1m2 ( j ) ) + em2∗r3m2 − r1m2∗ s i n ( theta1m2 ( j ) ) ) ;
230 hm2=fm2^2− 2∗fm2 ∗( r1m2∗ c o s ( theta1m2 ( j ))−r3m2)−2∗r1m2∗r3m2∗ c o s ( theta1m2 ( j ))+r1m2^2+r3m2^2−r2m2 ^ 2;

231
232 pyP2 ( j ) = ( − gm2 + s q r t ( gm2.^ 2 − 4∗dauxm2∗hm2) ) / ( 2∗dauxm2 ) ;
233 pxP2 ( j ) = em2∗pyP2 ( j ) + fm2 ;

234
235 %TRASLADO AL SISTEMA ORIGINAL DEL SEGUNDO MECANISMO DE 5 BARRAS
236 p2 ( j ) = s q r t ( pxP2 ( j )^2 + pyP2 ( j ) ^ 2 );
237 THETA2p2( j ) = atan2d ( pyP2 ( j ) , pxP2 ( j ) ) ;
238 the t a 2p 2 ( j ) = deg2rad (THETA2p2( j ) ) ; %Ang . d el punto P2 r e s p e c t o a l si s t em a s e c . en rad .

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

247
248
249 %CALCULOS PARA EL SEGUNDO MECANISMO DE 4 BARRAS

250
251 THETA14B2( j ) = atan2d ( pyS2 ( j ) − pyIFP ( j ) , pxS2 ( j ) − pxIFP ( j ) ) ;
252 theta14B2 ( j ) = deg2rad (THETA14B2( j ) ) ; %Angulo de bancada mecanismo 4B 2 en r a di a n e s 253 THETA24B2( j ) = atan2d ( pyP2so ( j ) − pyS2 ( j ) , pxP2so ( j ) − pxS2 ( j ) ) ;
254 | i f THETA24B2( j )<0
255 | THETA24B2( j ) = 360 + THETA24B2( j ) ;

256 end
257 theta24B2 ( j ) = deg2rad (THETA24B2( j ) ) ; %Angulo de manivela mecanismo 4B 2 en r a di a n e s

258

259 k1m2=d2∗ c o s ( theta14B2 ( j ))+ a2∗ c o s ( theta24B2 ( j ) ) ; 260 k2m2=d2∗ s i n ( theta14B2 ( j ))+ a2∗ s i n ( theta24B2 ( j ) ) ; 261 k3m2=k1m2^2+k2m2^2+c2^2−b2 ^ 2;
262 k4m2=−c2^2+b2^2+k1m2^2+k2m2^ 2;
263 A1m2=−k3m2−2∗k1m2∗ c2 ;
264 B1m2=4∗k2m2∗ c2 ;
265 C1m2=2∗k1m2∗c2−k3m2 ;
266 A2m2=k4m2−2∗k1m2∗b2 ;
267 B2m2=4∗k2m2∗b2 ;
268 C2m2=2∗k1m2∗b2+k4m2 ;

269
270 %C al c ul o de p o s i c i o n e s a n g ul a r e s
271 tantheta31m2=(−B2m2+s q r t (B2m2^2−4∗A2m2∗C2m2 ) ) / ( 2 ∗A2m2 ) ; 272 tantheta32m2=(−B2m2−s q r t (B2m2^2−4∗A2m2∗C2m2 ) ) / ( 2 ∗A2m2 ) ; 273 tantheta41m2=(−B1m2+s q r t (B1m2^2−4∗A1m2∗C1m2 ) ) / ( 2 ∗A1m2 ) ; 274 tantheta42m2=(−B1m2−s q r t (B1m2^2−4∗A1m2∗C1m2 ) ) / ( 2 ∗A1m2 ) ; 275 theta3cm2 ( j )=2∗ atan ( tantheta31m2 ) ;
276 theta3am2 ( j )=2∗ atan ( tantheta32m2 ) ;
277 theta4cm2 ( j )=2∗ atan ( tantheta41m2 ) ;
278 theta4am2 ( j )=2∗ atan ( tantheta42m2 ) ;
279 THETA3cm2( j )=2∗ atan ( tantheta31m2 )∗1 8 0 / pi ; % t h e t a 3 c ruz ad o en g r ad o s 280 THETA3am2( j )=2∗ atan ( tantheta32m2 )∗1 8 0 / pi ; % t h e t a 3 a b i e r t o en g r ad o s
281 | i f THETA3am2( j )<0
282 | THETA3am2( j ) = 360 + THETA3am2( j ) ;

283 end
284 THETA4cm2( j )=2∗ atan ( tantheta41m2 )∗1 8 0 / pi ; %t h e t a 4 c ruz ad o en g r ad o s 285 THETA4am2( j )=2∗ atan ( tantheta42m2 )∗1 8 0 / pi ; %t h e t a 4 a b i e r t o en g r ad o s
286 | i f THETA4am2( j )<0
287 | THETA4am2( j ) = 360 + THETA4am2( j ) ;

288 end

289
290 % Obteniendo l a s c o o rden ad a s d el punto P3
291 pxP3 ( j ) = pxIFP ( j ) + c2 ∗ c o s ( deg2rad (THETA4am2( j ) ) ) ; 292 pyP3 ( j ) = pyIFP ( j ) + c2 ∗ s i n ( deg2rad (THETA4am2( j ) ) ) ;

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

297
298 pxIFD ( j ) = fm∗ c o s ( the ta fm ( j ) ) + pxIFP ( j ) ;
299 pyIFD ( j ) = fm∗ s i n ( the ta fm ( j ) ) + pyIFP ( j ) ;

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

306
307 end

308
309 % Rutas de t r a z o c omple t a s
310 f i g u r e ( 3 6 )
311 pl o t ( pxIFP , pyIFP , ’ DisplayName ’ , ’ Ruta␣Art . ␣IFP ’ ) 312 h old on
313 pl o t ( pxIFD , pyIFD , ’ DisplayName ’ , ’ Ruta␣Art . ␣IFD ’ ) 314 pl o t (pxPF , pyPF , ’ DisplayName ’ , ’ Ruta␣ punto ␣ Fi n al ’ ) 315 s c a t t e r (−r3 ,−d , ’ f i l l e d ’ , ’ DisplayName ’ , ’ Art . ␣MCF’ ) 316 s c a t t e r ( 0 , 0 , ’ f i l l e d ’ , ’ DisplayName ’ , ’ Origen ’ )
317 t i t l e ( ’ Ruta␣ de ␣ cada ␣ f a l a n g e ’ )
318 x l a b e l ( ’ Coordenadas ␣ en ␣X␣ (mm) ’ )
319 y l a b e l ( ’ Coordenadas ␣ en ␣Y␣ (mm) ’ )
320 g ri d on
321 % l e g e n d ( { ’ Ruta␣Art . ␣IFP ’ , ’ Ruta␣Art . ␣IFD ’ , ’ Ruta␣ punto ␣ Fi n al ’ , ’ Art . ␣MCF’ , ’ Origen ’ } 322 % , ’ L o c a ti o n ’ , ’ s o u t h e a s t ’ , ’ O ri e n t a ti o n ’ , ’ v e r t i c a l ’ ) ;
323 l e g e n d ( { ’ Ruta␣Art . ␣IFP ’ , ’ Ruta␣Art . ␣IFD ’ , ’ Ruta␣ punto ␣ Fi n al ’ , ’ Art . ␣MCF’ , ’ Origen ’ } ) ; 324 h old o f f
