Utemita/Optimizacion_Exo2/diagrama_mecanismo_completo.png

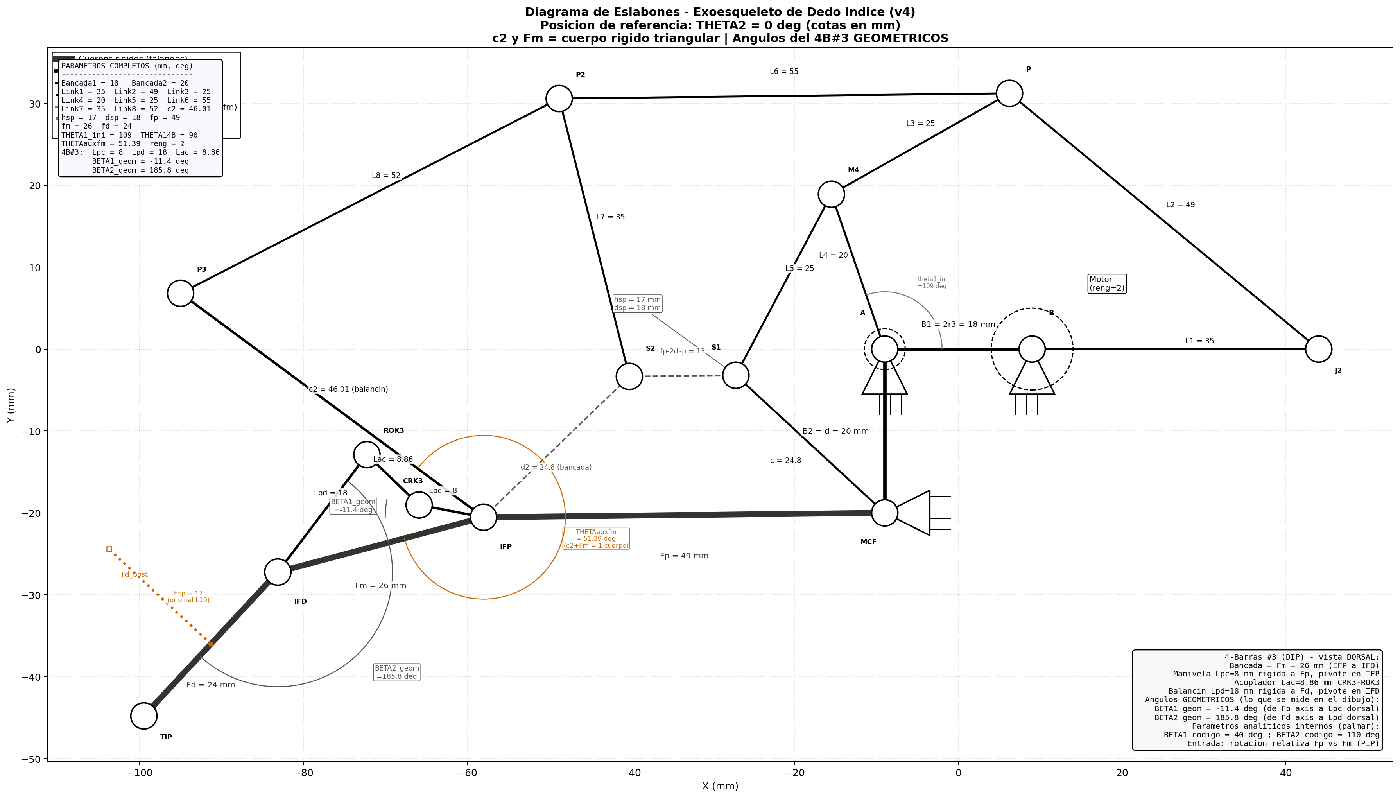
diagrama_mecanismo_completo.png
