Utemita/Optimizacion_Exo2/plano_4B3_general.png

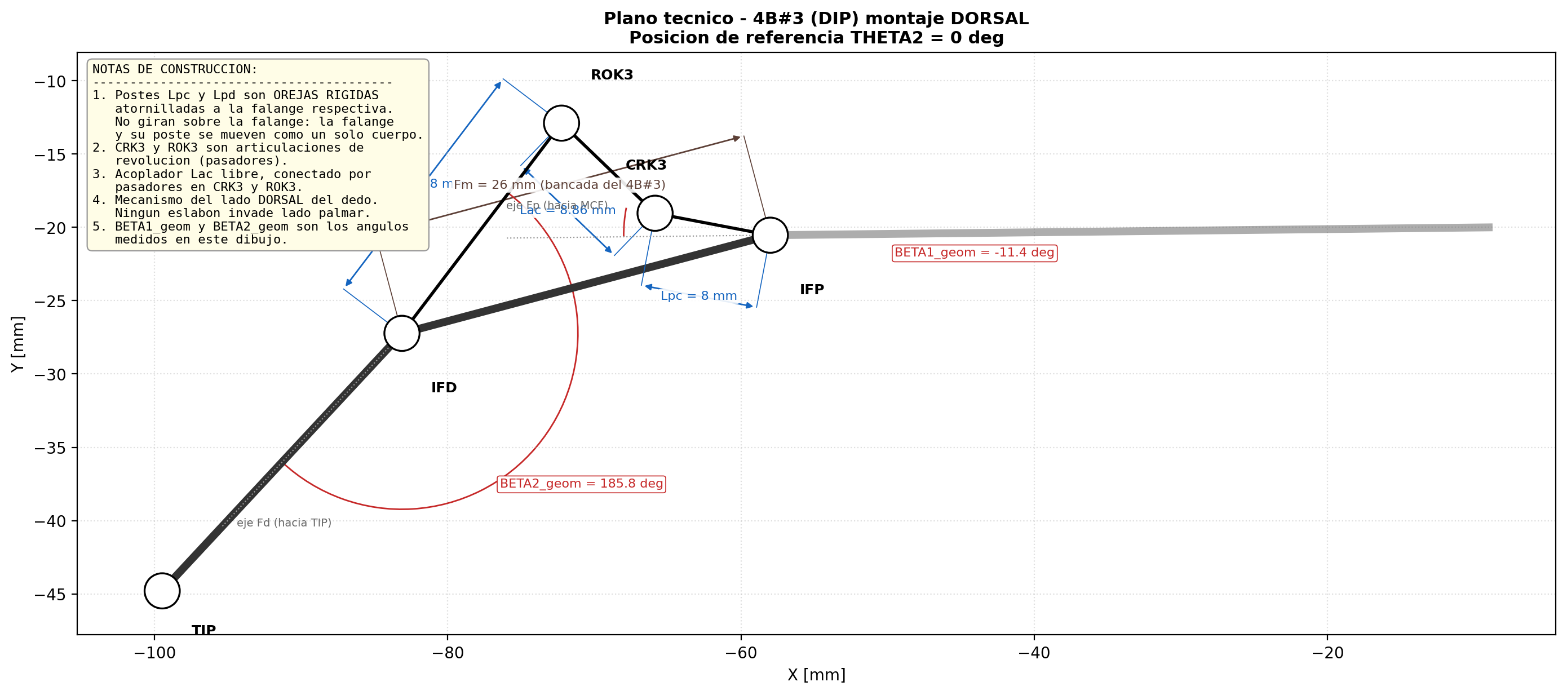
plano_4B3_general.png
