Utemita/Optimizacion_Exo2/plano_4B3_piezas.png

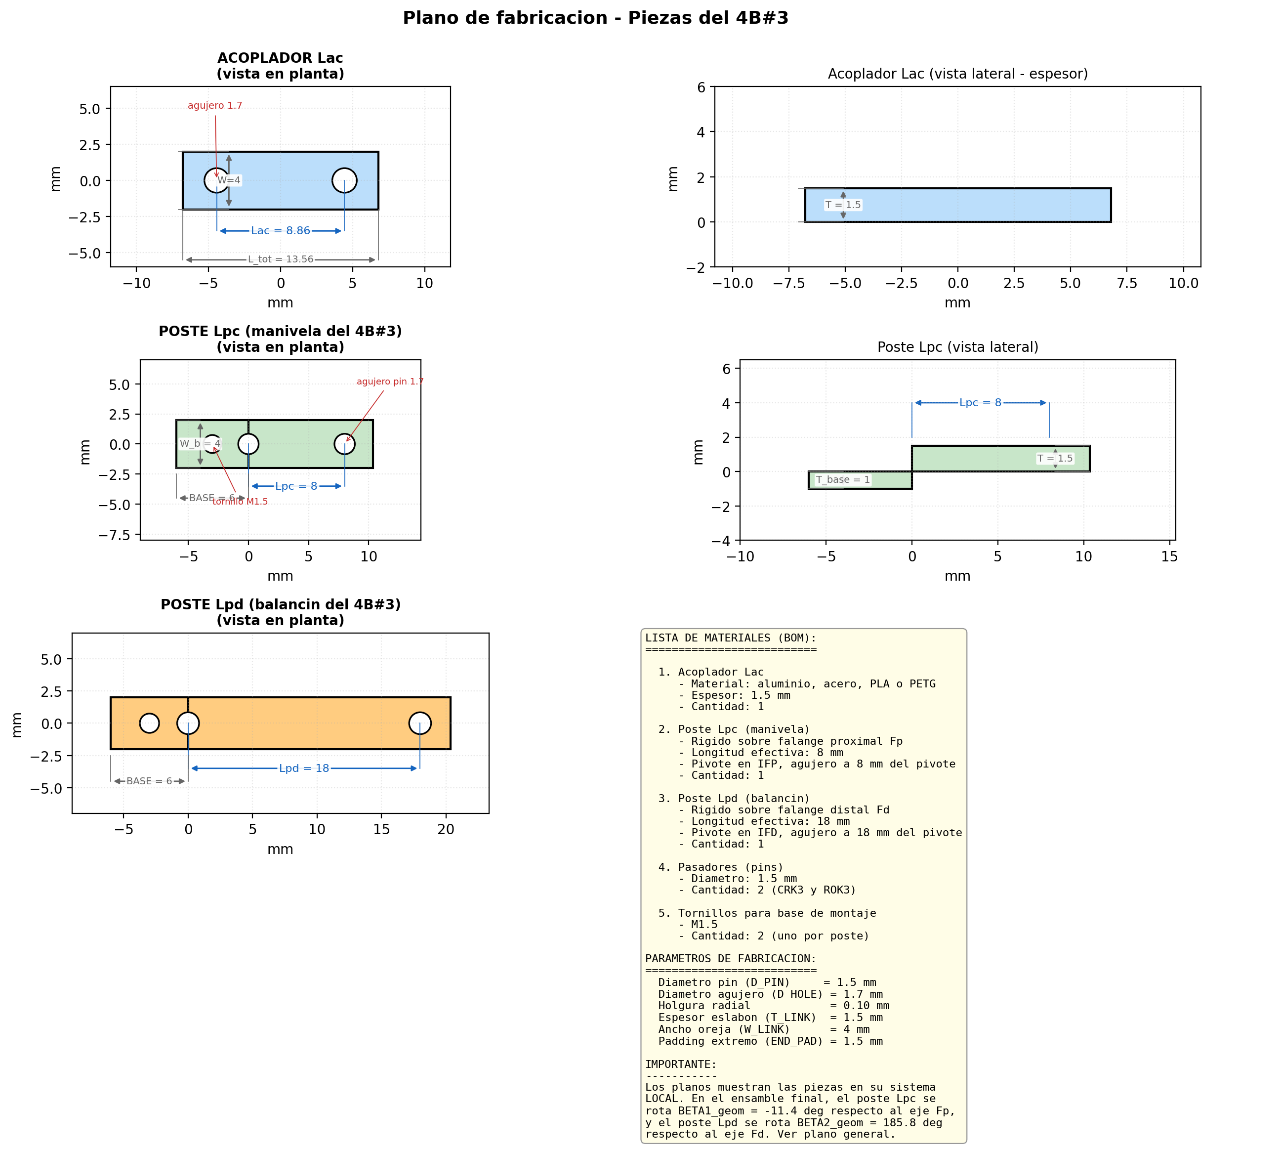
plano_4B3_piezas.png
