Utemita/Optimizacion_Exo2/step_4B3/poste_Lpc.step

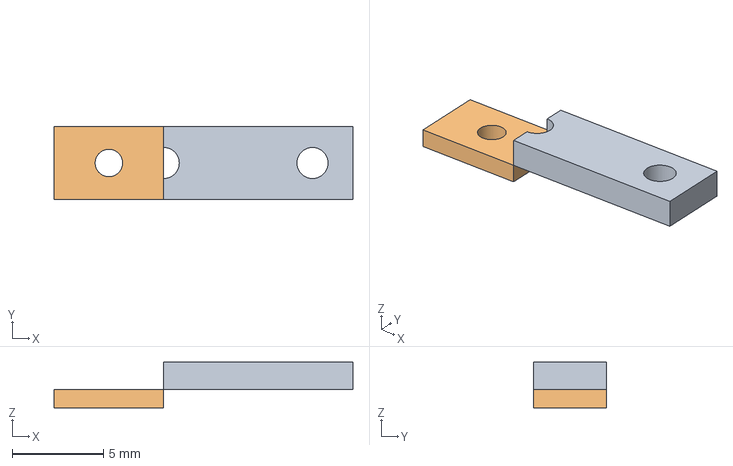
[picture p26: CAD file, 2026-06-07]
step_4B3/poste_Lpc.step
16.4 x 4.00 x 2.50 mm
