Utemita/Optimizacion_Exo2/step_4B3/pasador.step

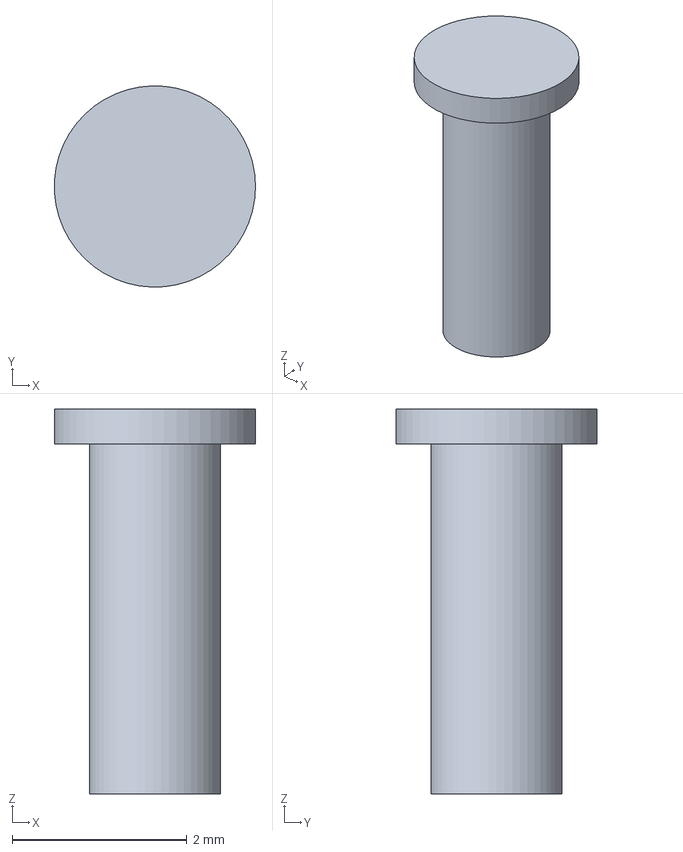
[picture p27: CAD file, 2026-06-07]
step_4B3/pasador.step
2.30 x 2.30 x 4.40 mm
