Utemita/Optimizacion_Exo2/step_4B3/acoplador_Lac.step

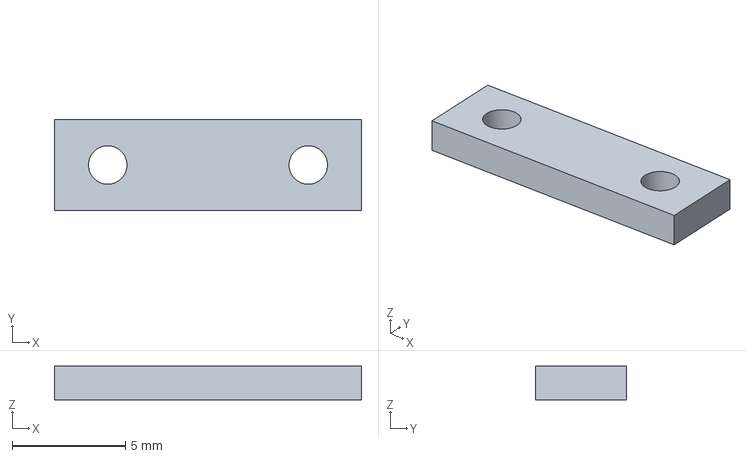
[picture p28: CAD file, 2026-06-07]
step_4B3/acoplador_Lac.step
13.6 x 4.00 x 1.50 mm
