Utemita/Optimizacion_Exo2/step_4B3/poste_Lpd.step

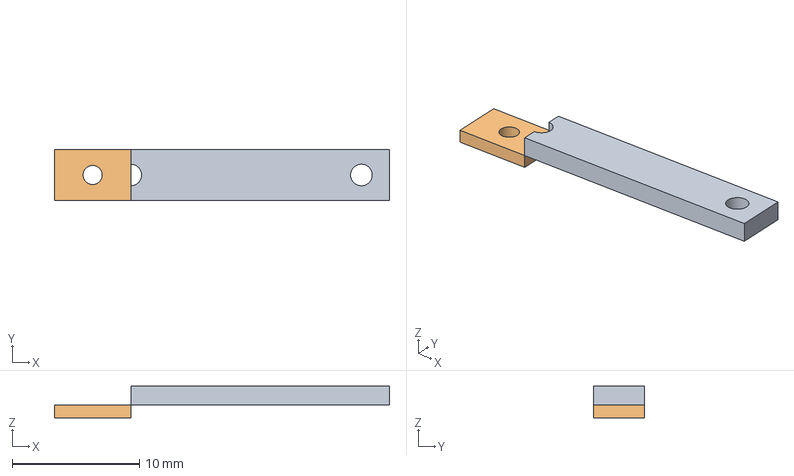
[picture p29: CAD file, 2026-06-07]
step_4B3/poste_Lpd.step
26.4 x 4.00 x 2.50 mm
