Utemita/Optimizacion_Exo2/(list of files, cad)

Other CAD files:
step_4B3/acoplador_Lac.stl
step_4B3/pasador.stl
step_4B3/poste_Lpc.stl
step_4B3/poste_Lpd.stl
