Utemita/Optimizacion_Exo2/Resultados_DIP_Variable.csv

x_ifp_mocap | y_ifp_mocap | x_ifp_exo | y_ifp_exo | x_ifd_mocap | y_ifd_mocap | x_ifd_exo | y_ifd_exo | x_tip_mocap | y_tip_mocap | x_tip_exo | y_tip_exo
0.0489841262937444 | 0.001247145235527305 | 0.04730409558939096 | 0.013379044780538262 | 0.07496727714027682 | 0.0021830256158866922 | 0.07284292023880708 | 0.008503756529944756 | 0.09894469138171481 | 0.00322398973365757 | 0.0956818101427829 | 0.015878382483447123
0.04898187682019953 | 0.0013325701372912371 | 0.04713852130674921 | 0.013943547820837354 | 0.074963347163912 | 0.0023139970468415987 | 0.07273185070280537 | 0.009362992131298441 | 0.09893889294213914 | 0.003397142760092781 | 0.09548428742795641 | 0.01700017898694092
0.04897589389312228 | 0.0015368205391744576 | 0.04696848969644543 | 0.014498646127425588 | 0.07494975014346299 | 0.0027024926571548582 | 0.07261216434167105 | 0.010208896637092596 | 0.09891439727398746 | 0.004004678477015289 | 0.09527652930434533 | 0.018103613911238797
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
