Utemita/Optimizacion_Exo2/Resultados_DIP_Variable.png

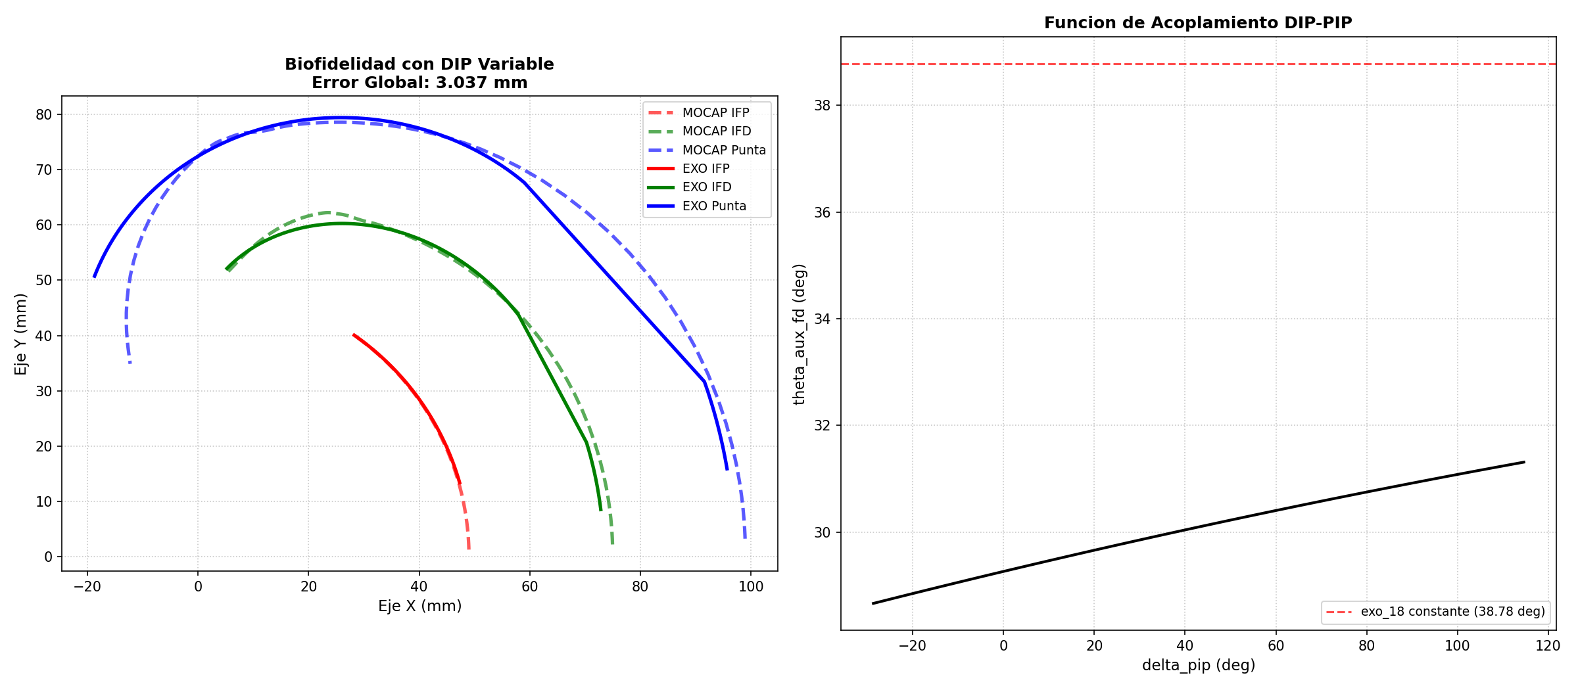
Resultados_DIP_Variable.png
