Utemita/Optimizacion_Exo2/sintesis_freudenstein_resultado.png

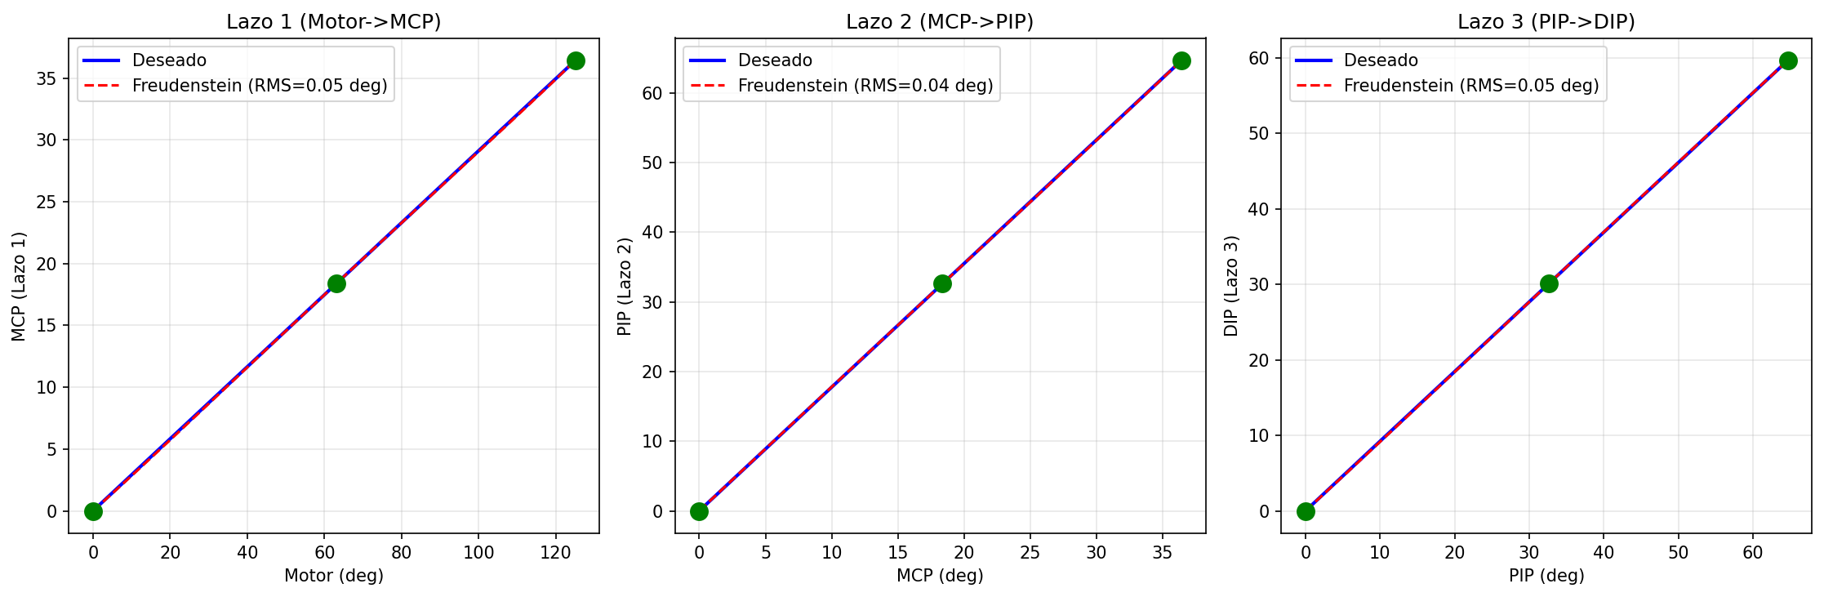
sintesis_freudenstein_resultado.png
