Utemita/Optimizacion_Exo2/verificacion_dip.png

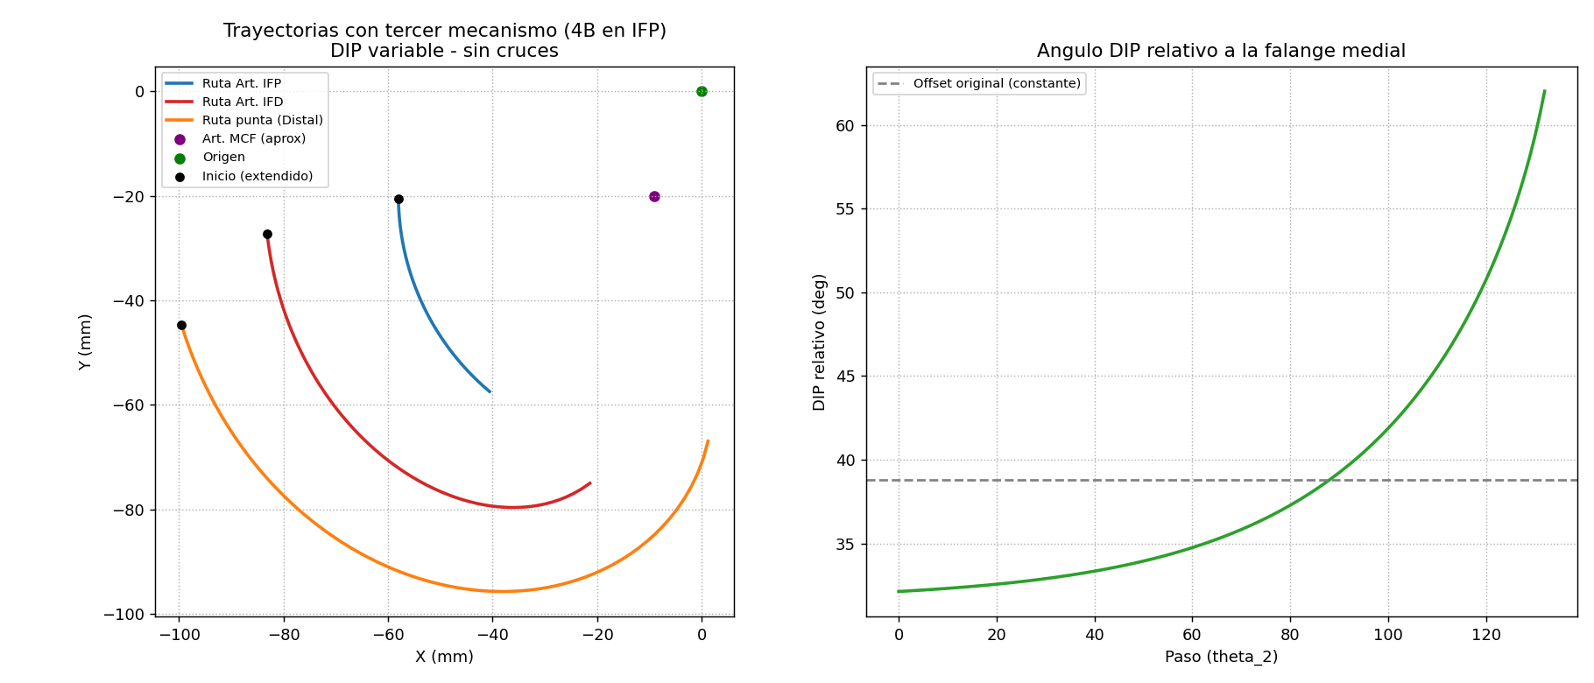
verificacion_dip.png
