Utemita/Optimizacion_Exo2/(commit log)

2026-06-07 feat(4B3): postes hsp, L9, plano cotado y STEP de eslabones del 4B#3
    - Diagrama: agregados postes hsp sobre Fm y Fd (mecanismo original).
    - Diagrama: agregado L9 entre P3 y poste hsp de Fm (materializa THETAauxfm).
    - Diagrama: angulos del 4B#3 ahora muestran valores GEOMETRICOS reales
    (BETA1_geom = -11.4 deg, BETA2_geom = 185.8 deg) en lugar de los
    parametros analiticos internos (40 y 110), que confundian al medir con
    transportador. Las trayectorias DIP (32 -> 62 deg, monotonas) se
    mantienen identicas.
    - Nuevos: plano_4B3.py + plano_4B3_general.png (vista cotada del 4B#3
    montado) y plano_4B3_piezas.png (planos de fabricacion individuales).
    - Nuevos: generar_step_4b3.py + step_4B3/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
    [acoplador_Lac.step, acoplador_Lac.stl, pasador.step, pasador.stl, poste_Lpc.step, poste_Lpc.stl, poste_Lpd.step, poste_Lpd.stl]
2026-06-07 docs(matlab): aclarar BETA1/BETA2 analiticos vs BETA_geom para CAD
    CinematicaExoModificada.m mantiene BETA1=40 y BETA2=110 (correctos para la
    formulacion analitica del lado palmar, rama '-' del arccos). Se agrega un
    bloque de comentarios explicando que los angulos para construir el CAD son
    BETA1_geom=-11.4 deg y BETA2_geom=185.8 deg (medidos en el dibujo dorsal),
    y que ambas convenciones describen el mismo mecanismo fisico. Una
    sustitucion directa de los valores rompe la trayectoria DIP (verificado
    numericamente: excursion cae a 23.96 deg y se pierde la monotonia).
2026-06-07 feat(optim): agregar exo2_1.py con cinematica del 4B#3 validada
    - Nuevo archivo exo2_1.py que sustituye a exo_18.py.
    - La cinematica ahora es la misma que CinematicaExoModificada.m (verificada:
    DIP 32.12 -> 62.03 deg, monotono).
    - Vector de parametros ampliado de 17 a 22: incluye Lpc, Lpd, Lac, BETA1,
    BETA2 (analiticos) y theta_aux_fd_fallback.
    - Funcion calcular_betas_geometricos() convierte los analiticos a los
    angulos GEOMETRICOS que se miden en el dibujo dorsal y se usan en CAD
    (BETA1_geom ~ -11.4 deg, BETA2_geom ~ 185.8 deg para params MATLAB).
    - Documentacion inline explica la diferencia entre las dos convenciones
    de angulo (analitica vs geometrica/CAD).
    - Al finalizar la opt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
2026-06-07 fix(4B2): c2 es eslabon real (solido), eliminar L9 y poste hsp sobre Fm
    Correcciones a la topologia del mecanismo 4B#2:
    - c2 (IFP-P3) ahora se dibuja con linea SOLIDA: es el balancin real
    del 4B#2, no una distancia virtual.
    - Se elimina L9: no existe como eslabon separado.
    - Se elimina el 'poste hsp sobre Fm': c2 y Fm son un UNICO cuerpo
    rigido triangular con angulo interno THETAauxfm = 51.39 deg.
    - Se agrega arco y anotacion del angulo THETAauxfm entre c2 y Fm
    para indicar que forman una sola pieza.
    - Se actualiza Guia_Ensamble_CAD.md: seccion 4.7 reescrita, seccion
    4.6 clarificada, tabla de restricciones (seccion 5) corregida.
    - El poste hsp sobre Fd (vestigial, punteado) se manti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
2026-06-08 docs: trayectorias de referencia limitadas a THETA2=0..125 deg (rango seguro)
    El mecanismo alcanza singularidad en ~132 deg de THETA2 (los eslabones se
    alinean y el solver dinamico de Adams/SolidWorks no puede continuar).
    Se limita el rango operativo a 0-125 deg para evitar el bloqueo.
    Flexion articular en el rango seguro (0 a 125 deg):
    MCP: 0.00 -> 46.34 deg (excursion 46.34 deg)
    PIP: 14.30 -> 68.79 deg (excursion 54.49 deg)
    DIP: 32.12 -> 54.36 deg (excursion 22.24 deg)
    TOTAL: 123.07 deg de flexion combinada
    Todas las articulaciones son monotonas crecientes (verificado).
    Archivo: trayectorias_referencia_125deg.csv (120 puntos)
    Columnas: THETA2, posiciones IFP/IFD/TIP, angulos abs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
    [trayectorias_referencia_125deg.csv]
2026-06-08 feat: add Freudenstein 3-loop synthesis for finger exoskeleton
    Implements complete 3-loop cascaded four-bar mechanism design:
    - Extracts fine-grasp (tip pinch) data from Pizzolato CyberGlove II database
    - Applies linear calibration for MCP, PIP, DIP joint angles
    - Uses Freudenstein 3-point synthesis with half-angle simulation
    - Exhaustive search over phi0, psi0, and ground link length
    - All 3 loops achieve RMS < 0.1 deg tracking error
    - Joint ranges: MCP 36.4 deg, PIP 64.6 deg, DIP 59.6-66.8 deg
    Output files:
    - agarre_fino_referencia.csv: reference trajectory data
    - resultados_freudenstein.txt: mechanism dimensions and results
    - sintesis_freudenstein_resultado.png: desired vs actual plots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
    [agarre_fino_referencia.csv]
2026-06-08 feat: add Pizzolato/Ninapro pinch grip MOCAP data with 70 deg DIP range
    - Download and analyze Ninapro DB1 CyberGlove II raw data from Zenodo
    - Process 26 subjects Exercise 2 (grasping) to find best pinch grip
    - Select subject S14 with highest DIP sensor range (173 raw units)
    - Calibrate raw sensors to joint angles using linear mapping
    - Apply biomechanical DIP-PIP coupling ratio (0.70) from literature
    - New mocap_pinch_pizzolato.csv: DIP 70 deg, PIP 100 deg, MCP 56 deg
    - Previous mocap_indice_120pts.csv had only 20 deg DIP range (3.5x improvement)
    - Add explorar_pizzolato.py for reproducible analysis of the dataset
    [mocap_pinch_pizzolato.csv]
2026-06-08 feat: add polynomial DIP coupling analysis and exo_19_dip_variable.py
    - Analisis_DIP_Solucion_Definitiva.md: comprehensive analysis of DIP fix options
    (polynomial coupling, linear coupling, 4B#3 mechanism, cam profile) with
    recommendation for quadratic polynomial approach
    - exo_19_dip_variable.py: modified exo_18 with variable DIP coupling
    - Replaces constant theta_aux_fd with polynomial: c0 + c1*delta_pip + c2*delta_pip^2
    - 19 parameters total (3 polynomial coefficients replace 1 constant)
    - Loads mocap_pinch_pizzolato.csv with 70 deg DIP range (fallback to old data)
    - Extracts closing phase from cyclic pinch data and resamples to 120 points
    - Adds DIP monotonicity constraint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
2026-06-08 fix: clamp DIP angle, tighten c2 bounds, trim flat MOCAP regions
    - Add np.clip(theta_aux_fd, 0, pi/2) after polynomial evaluation to
    prevent physiologically impossible DIP angles exceeding 90 degrees
    - Reduce coeff_fd_2 bounds from [-5, 5] to [-2, 2] to prevent extreme
    quadratic contributions while still allowing sufficient curvature
    - Add flat-region trimming after closing phase extraction and resampling:
    detects rows where all 3 angles change < 0.5 deg total and trims them
    from the start and end, then re-resamples to 120 dynamic points
2026-06-08 feat: add exo_19 optimization results - 3.037mm global error with polynomial DIP coupling
    [Parametros_DIP_Variable.txt, Resultados_DIP_Variable.csv]
